www1453/trustscope/README.md

# TrustScope

## 1. 这是什么

TrustScope 是一台停带式来料检验工位：双 OV5640 经 PL 采集 1280×720 画面，三态判决在板端
裸机 PS 完成；缺角的四角覆盖通道在工位控制端运行（两通道设计见报告 §2.3）。它只回答一个
问题——这块板能不能判：输出 **OK / NG / 无法判定** 三态，判不了的一律判“无法判定”，绝不计为合格。
判定路径可审计：160×90 格逐格比对，每格 8×8 px = 0.4 mm/格，格均值差 > 30 灰且最大
8 连通组 ≥ 8 格判 NG。整张作业单 111 块板的实测结果见下一节。

## 2. 实测指标

以下为现场实测指标块原文（逐板 2026-11-01、连续运行 2026-11-02 夜→11-03 晨），**冻结不改写**；
它由 `data/` 里随仓库提交的数据算出，复算命令见 §3.2。

Field results (whole work order, 111 boards = B001-B100 + C101-C111, 2026-11-01 evening):
capability-internal detection **72.7%** (40/55 — contamination 18/25, bent 10/15, corner chips 12/15);
main-run anchor, batch 1-5 single session **75.0%** (36/48); good-board false alarms in two labelled
scopes — single run, production scope **15.0%** (6/40), and re-test adjudicated **8.8%** (3/34; 3/40 =
7.5% of all boards); fine scratches **0%** (0/16, a known capability boundary stated in the report).
Continuous run: 10.20 h, 12,626 samples, 99.7% OK (12,594), 0 NG, 32 refusals (0.3%, all inside the
first 30 min — a start-up transient), 1 restart (cause not located; verdicts consistent after).

The report states three limits explicitly: fine scratches pass by design, the CNN is implemented
but not in the verdict path, and hole/notch inspection is not implemented.

## 3. 复现（两条腿）

### 3.1 工具链腿：Vivado / Vitis 2023.1

**AMD Vivado / Vitis 2023.1** —— 硬件设计与 PS 裸机工程都用这个版本。赛纲 3.3.3.1 推荐 2026.1 / 2025.2，并要求其他版本在报告中说明且脚本可复现：版本声明见报告，可复现构建见 [`src/build/`](src/build/)。
器件 **XC7Z020（ALINX AX7020）**；10-24 出货构建 FCLK_CLK0 50.000 MHz，
WNS +0.908 ns / TNS 0 / WHS +0.037 ns，未满足约束的端点 0/140,009。

- **引脚约束**：[`src/two_fft.xdc`](src/two_fft.xdc)。16 条第二路相机引脚逐脚对照厂商 `an5642.xdc`，
  LCD 引脚对照厂商 `lcd_test.xdc`；改引脚号之前先对该表。
- **PS 裸机程序**：[`src/main.c`](src/main.c)（相机、I2C、MMU + D-cache、显示、判定主循环）；
  固件戳由 13 个源文件生成，见 [`src/build_id.h`](src/build_id.h)。
- **传送带侧固件**：[`src/stm32_conveyor_main.c`](src/stm32_conveyor_main.c)。
- **HLS CNN 与构建**：[`src/hls/`](src/hls/)（CNN 核、同源测试台、HLS 驱动；**不在判决路径上**）、
  [`src/build/`](src/build/)（Block Design 集成、构建与 XSA 导出 Tcl；**不含比特流**）。
- **构建与上板**：本仓库只带源码、约束与构建 Tcl，**不带 Vivado 工程、比特流、上板脚本**。从零构建的
  模块清单、资源与时序见报告 §2.3–§2.4 与 §6.2；上板的脚本序列与寄存器块记录在
  [`docs/HISTORY_20261021.md`](docs/HISTORY_20261021.md) 的“上板”一节——那里的 `ps_fft_dual/`、
  `ps_ui/` 路径取自 10-21 工作树，本仓库不含这两个目录，按记录原样保留，不作为本仓库的命令。

### 3.2 数据腿：三条命令

在仓库根目录执行；输入是 `data/` 里随仓库提交的实测 CSV，**不需要板子**。
Python 3.11+，只用标准库（画报告插图的 `tools/make_report_figures_20261103.py` 另需 `matplotlib`）。

```powershell
python tools/recompute_field_20261103.py     # 逐类检出率与误报率
python tools/threshold_sweep_20261103.py     # 限值 4-10 的工作点曲线
python tools/soak_20261101.py --report       # 10.20 h 连续运行的可靠性四项
```

各自打印什么（都能复算回第 2 节）：

- `recompute_field_20261103.py` → `IN-SCOPE DETECTION (adjudicated, all batches) : 40/55 = 72.7%`；
  `main-run-only anchor (batch1-5, one session) : 36/48 = 75.0%`；
  `false-alarm : 3/34 = 8.8% (judgeable) | 3/40 = 7.5% (all)`；
  `main run : NG 6 / UNSTABLE 3 / CANNOT 1 / OK 30`（即单次现场口径 6/40 = 15.0%）；
  逐类 `pollution 18/25 = 72.0%`、`bent 10/15 = 66.7%`、`corner 12/15 = 80.0%`、
  `scratch 0/16 = 0.0%`；末行 `ledger total: 111 boards = g40 + c25 + b15 + s16 + k15`。
- `threshold_sweep_20261103.py` → 表头 `t | good FA | pollution | bent | scratch | in-scope det`
  加 7 行（t=4…10）。t=8 行：良品误报 `6/36 = 16.7%`、能力内检出 `36/48 = 75.0%`；
  t=4 行：检出 `42/48 = 87.5%` 对误报 `14/36 = 38.9%`；收尾 `corner channel (independent): 12/15 = 80.0%`。
- `soak_20261101.py --report` → `rows : 12626`、`duration : 10.20 h  (36725.7 s)`、
  `mean sampling period: 2.9 s`、`OK 12594 (99.7 %)`、`NG 0 (0.0 %)`、`CANNOT 32 (0.3 %)`、
  `重启 (frame counter decreased) : 1`（帧计数下降 1 次）。

## 4. 导航

**目录对照（赛题 3.3.5.4：本仓库采用与推荐结构不同的组织方式，对照表放在本文件内）**

| 推荐结构 | 本仓库 | 内容 |
|---|---|---|
| `src/` | `src/` | PS 裸机 C（`main.c`）、PL 管脚约束（`two_fft.xdc`）、STM32 固件（`stm32_conveyor_main.c`）、HLS CNN（`hls/`）、构建 Tcl（`build/`） |
| `sim/` | — | 未分发；离线复算与五维否证见报告 §4 与 `tools/` |
| `build/` | `tools/` | 复算、阈值扫描、soak 报告、画图脚本 |
| `board/` | `docs/` | 上板与测量记录（250 份，按日期命名） |
| `data/` | `data/` | 现场 CSV、soak 采样、结果表 |
| `skill/` | `skill/` | 技能包（提示词模板 / 踩坑清单 / 校验脚本） |
| `report/` | `report/` | 设计报告（`trustscope_report.pdf`）+ 大模型协作记录（`llm_collaboration.md`、`llm_collaboration_evidence.md`） |
| `README.md` | `README.md` + `README.en.md` | 中英各一 |

- **完整设计报告**：[`trustscope_report.pdf`](report/trustscope_report.pdf)（27 页，含全部实测照片与数据）。
- **提交后勘误与补充**：[`docs/REPORT_ADDENDUM_20261104.md`](docs/REPORT_ADDENDUM_20261104.md)（节拍两态 + soak 不连续的准确表述）。
- **日期化工程记录**：[`docs/`](docs/)（250 个文件，按文件名日期排序）。先读
  [`docs/HISTORY_20261021.md`](docs/HISTORY_20261021.md) 顶部的三速率表——18.0 fps / 8.7–10.3 fps /
  约 1.6 次/秒不是同一个量。
- **数据与图**：[`data/`](data/)（实测 CSV、现场结果）、[`figures/`](figures/)（报告插图）。
- **技能包与检查脚本**：[`skill/`](skill/)。
- **大模型协作记录**：正文 [`report/llm_collaboration.md`](report/llm_collaboration.md) + 工程细节 [`report/llm_collaboration_evidence.md`](report/llm_collaboration_evidence.md)；证据索引 [`docs/AI_COLLABORATION_RECORD.md`](docs/AI_COLLABORATION_RECORD.md)（赛纲 3.3.5.3）。
- **目录对照（选题指南 3.3.5.4）**：[`docs/DIRECTORY_MAP_20261103.md`](docs/DIRECTORY_MAP_20261103.md)。
- **English version**：[`README.en.md`](README.en.md)。
