www1453/trustscope/docs/REPORT_ADDENDUM_20261104.md

# REPORT ADDENDUM — 2026-11-04

提交材料冻结（固件戳 TSC1CC73517D）之后、提交日当天整理的两个测量结论。
本文件只补充测量事实与口径，不改变报告任何指标；与报告正文表述不一致处，以本文件为准。
复算不依赖板子，命令见 §3（与 README §3.2 相同）。

## 1. 主循环节拍是"两个状态"，不是一个数字

| 状态 | 主循环判决节拍 | 出现条件 | 恢复性 |
|---|---|---|---|
| 冷启动态 | 8.07–8.28 Hz | 上电后首轮运行 | 可重复 |
| 退化态 | 约 1.6 Hz | 长时间运行 + 大量 JTAG 交互之后 | 三步重载不恢复；断电冷启动恢复 |

- 18.0 fps 是采集侧（PL + VDMA）速率；8.7–10.3 s/件 是报告表 1-1 的历史口径；约 1.6 Hz 与
  8.07–8.28 Hz 是 PS 主循环两个状态的实测。四个数不是同一个量，见
  [docs/HISTORY_20261021.md](HISTORY_20261021.md) 顶部三速率表。
- "降速只在退化态出现、断电冷启动后消失"这一事实是提交冻结后复测得到的，故在此补记。
  降速根因未定位；报告正文已按"两状态节拍"表述。

## 2. 10.2 h 连续运行（soak）的准确表述

- 主张：10.20 h 窗口内 12,626 次采样判决，12,594 次 OK（99.7%）、0 次 NG、32 次拒判（0.3%，
  全部集中在前 30 分钟的启动暂态）、1 次重启（帧计数下降，机制未定位）。
- 不主张："10.20 h 无间断连续运行"。物理行 12602 处存在一次记录不连续
  （t_ms 36,739,275 → 460 → 36,656,969；帧计数 61,408 → 60,223），其后 69 秒内 24 次采样判决正常。
- 采样全程处于退化态（约 1.64 Hz）——soak 测的是退化态可靠性，不是冷启动态。
- 复算：`python tools/soak_20261101.py --report`

## 3. 复算命令

```powershell
python tools/recompute_field_20261103.py     # 逐类检出率与误报率
python tools/threshold_sweep_20261103.py     # 限值 4-10 工作点曲线
python tools/soak_20261101.py --report       # 10.20 h 连续运行四项
```
