www1453/trustscope/docs/OPTICS_RECOMMENDATION_20261019.md

# 光学与分辨率建议（一页）

> 对象：AX7020 + AN5642（OV5640）双相机，检测裸 PCB，板 **64 × 44 mm**。
> 依据：`docs/DETECT_LIMITS_20261019.md` 的实测（1280×720 覆盖全板）。

## 现状：0.119 mm/px

横向 `64 mm / 527 px = 0.121`，纵向 `44 mm / 379 px = 0.116`，取 **0.119 mm/px**。

| 目标缺陷 | 需要 | 现状（0.119 mm/px） | 结论 |
|---|---|---|---|
| 缺铜/桥连/破孔 ≥0.5 mm | 4 px | 4 px ≈ 0.48 mm | **可检**（中/高对比度） |
| 低对比度缺陷 ≥1 mm | 8 px | 8 px ≈ 0.95 mm | **可检** |
| 走线断口 0.3 mm | 2.5 px | 2.5 px | **低于下限** |
| 走线断口 0.2 mm | 1.7 px | 1.7 px | **低于下限** |
| 走线断口 0.1 mm | 0.8 px | 0.8 px | **远低于下限** |

## 若验收标准是 0.1 mm 级缺陷

需要 **0.025 mm/px**（让 0.1 mm 占 4 px）。两条路：

| 方案 | 需要的水平像素 | 一次拍完？ | 成本/工作量 |
|---|---|---|---|
| **A. 换 5 MP 传感器**（如 2592×1944），视野不变 | **2592 px**（需 ≥2560） | ✅ 是 | 换模组 + 重配 DVP/时序/VDMA（PS 侧分辨率常量、VDMA HSIZE/stride、UI 缩放比） |
| B. 保持 1280×720，视野缩到 16 mm 宽 | 1280 px | ❌ 需 **4×3 = 12 次拍摄** | 加机械 XY 或传送带定位；节拍变成 12 倍 |

**建议 A**：一次拍完，节拍不变，主要改动集中在"分辨率常量"与"视野/焦距"两处；
B 会让节拍从"单板 1 次"变成"单板 12 次"，且引入定位误差源。

## A 方案在软件上的连锁改动（提前列出，避免低估）

| 位置 | 现在 | 改后 |
|---|---|---|
| `ps_ui/main.c` 的 `CAM_W/CAM_H` | 1280×720 | 2592×1944 |
| VDMA `HSIZE/STRIDE` | 3840 | 2592×3 = 7776 |
| 帧存占用 | 2.76 MB/帧 | **11.3 MB/帧**（四帧存 = 45 MB，DDR 够，但布局要重排） |
| MMU 映射 | 15 MB 窗口 | 需扩大（每路四帧 = 45 MB） |
| 渲染缩放 | 1280→640（÷2） | 2592→640（÷4.05，需改盒平均核） |
| 检测极限 | 0.119 mm/px | **0.0247 mm/px** ⇒ 0.1 mm = 4 px ✅ |

## 结论（给决策用）

- **如果只要求粗缺陷（≥0.5 mm）**：当前硬件够，**不要改光学**，把精力放在配准与稳定性上；
- **如果要求 0.1 mm**：**换 5 MP 模组**，并预留"重排 DDR 布局 + 放大 MMU 窗口 + 改渲染缩放"的工时
  （按今天的经验，这是一次 BD 重建 + 一次固件重构，约 1–2 天，且需要上板验证）。

## 边界

- 上述换算基于**一次**实拍（64 mm 板占 527 px），未考虑镜头畸变与透视；
- 0.1 mm 的"4 px 可检"是指**在中/高对比度下**；低对比度仍需 8 px（0.2 mm）；
- 未评估 5 MP 下**曝光时间/帧率**的代价（像素多 4 倍，同样光照下每像素光子更少）。

---

## 10. PC 端 5 MP 处理耗时（2026-10-19 实测）

把 720p 真实帧放大到 **2592×1944**（只增加像素数，不增加真实细节），跑同一条检测链：

| 阶段 | 1280×720 | 2592×1944 |
|---|---|---|
| 配准（金字塔） | 7.0 ms | **110.2 ms** |
| 平移对齐 | 13.6 ms | 68.8 ms |
| **差分（两侧高斯+相减）** | **42.2 ms** | **209.2 ms** |
| 阈值 | 0.8 ms | 5.4 ms |
| 形态学开 | 10.3 ms | 50.5 ms |
| 连通域标记 | 2.9 ms | 13.7 ms |
| **合计** | **76.9 ms** | **457.8 ms** |

- 像素比 5.47×，耗时比 **5.95×**（近似线性，说明没有隐藏的 O(n²) 行为）；
- **差分是热点**（5 MP 下 209 ms / 458 ms = 46%），优化应从这里开始；
- 配准在 8 像素粗网格上完成，**精度只有 ±8 px**（例子中真值 (6,−10) 恢复成 (8,−8)）——
  真实实现需要再加一级细化，代价约 +30 ms。

### 结论

**电脑侧在 5 MP 下约 0.46 秒/板**，而停带-稳定本身通常 0.5–2 秒 ⇒ **计算不是瓶颈，机械节拍才是**。
这条数据支持"5 MP 方案可行"，但**不构成**"检测精度足够"的证据（放大不产生细节）。
