www1453/trustscope/docs/RUN_20261030.md

# 2026-10-30 重扫操作卡（冻结增益验证）

> 站台当前状态（我已经做完，你不用管）：
> - 位流 `BIT_20261028_plfe_attempt.bit` 已载，两路相机 live
> - 固件 **`TSC1BE7E51A4`**（只含冻结增益）已烧
> - 曝光钉在 **8662**（AEC 自己收敛的值），`mean 529‰`、`clip 0`、`aec=1`
> - 背景已采：`bg_state=1`、`bg_medd=1`、**`bg_cells=1`**（14400 格里 1）
> - 冻结在生效：`frz_scale=256`(=1.0)、`frz_bias=512`(=0)、`frz_state=0x0103`（位0=1）

---

## 第 0 步：确认没有东西挡着（30 秒）

```powershell
cd C:\Users\user\Documents\trustscope
```

**屏幕上应该看到**：绿板区域干净、没有大面积绿色掩膜点。

---

## 第 1 步：扫 76 块原样板（约 25 分钟）

```powershell
python dl\host_qc\sweep.py --ref-label g0
```

**它会依次问你**：

```
[A] place the REFERENCE board (a known-good board, label g0) ... press Enter>
    → 放一块【确定表面干净】的良品，回车
    → 要看到：part_ref >= 400、MB_DIFF_OK=1、refq ... state=0（或 state=3 但 decl 说明清楚）
    → 若出现 "REFUSING TO START"：把那段贴给我，别硬来

board 1: place it, then press Enter  [q = finish]>
    → 放一块板，回车

board 1: label it (gN good / dN defective)>
    → 打标签，回车
```

**标签必须与 10-29 那批一模一样（顺序无所谓，配对按标签）**：

| 类别 | 标签 | 数量 |
|---|---|---|
| 良品 | `g0` … `g40` | 41 |
| 污染 | `d1` …（按原来的号）| 21 |
| 划伤 | 原来的号 | 12 |
| 缺角 | 原来的号 | 2 |

**跑完按 `q` 回车**。它会打印 `rows written : N`。

---

## 第 2 步：扫 10 块缺角板（约 4 分钟，另一个文件）

```powershell
python dl\host_qc\sweep.py --ref-label g0
```

- 参考板：**再放一块干净良品**（它会重新取参考，这是正常的）
- 然后 10 块缺角板，标签 **`d40` … `d49`**
- 跑完按 `q`

**注意**：这 10 块**不要**混进第 1 步的文件——它们是另一个 CSV，只用来量缺角的真实比例。

---

## 第 3 步：出配对表

把第 1 步结束时的 **CSV 路径**（屏幕上会打印）填进下面：

```powershell
python dl\host_qc\pair_compare.py `
  --old dl\host_qc\logs\sweep_20261029_181623_sweep.csv `
  --new "<第1步的CSV完整路径>" `
  --require-freeze
```

**它会打印**：

- 每类的**检出前后**（污染、划伤、缺角）
- 每类的**误判前后**
- **逐板 DAREA 配对差**（同一标签前后）
- **McNemar 精确检验的 p 值**（已修正为双侧，不会再翻倍）
- 良品分布 min/median/max，以及 5 和 7 的计数
- **冻结证据解码**（`frz_scale/bias/state`）——`--require-freeze` 会拒绝没有冻结证据的文件

**它会在这些情况下拒绝运行（exit 2/3）**：
- 标签集合与旧文件不同（会点名哪些标签变了）
- 文件里读不到冻结证据

---

## 第 4 步：缺角比例（可选，一条命令）

```powershell
python dl\host_qc\sweep_report.py "<第2步的CSV完整路径>"
```

---

## 判据（先写下来，不许事后改）

| # | 预测 | 成立条件 |
|---|---|---|
| ① | 良品尾巴收窄 | max **从 7 降到 ≤4**，且**没有一块 ≥6** |
| ② | 三块污染被收进 | **d7 / d9 / d13 从 5 升到 ≥6** |
| ③ | 误判消失 | **从 1 块降到 0 块** |
| ④ | 划伤不变 | **仍是 1/12**（冻结不解决这一类） |

**任何一条不成立 → 就写"预测失败"**，报告里照写。

---

## 出问题时

| 现象 | 意思 | 怎么办 |
|---|---|---|
| `REFUSING TO START ... the reference is not clean` | 参考板本身有瑕疵 | 换一块更干净的良品 |
| `no new comparison in 20 s` / `MB_DIFF_OK=5` | 配准拒绝（板子摆歪/出界） | 摆正；还不行按 `s` 记为拒判继续 |
| `aec_state=3` | AEC 卡住 | 停下，告诉我，我重钉曝光 |
| `bg_cells` 在扫描中变大 | 皮带动了或光变了 | 停下，告诉我，重采背景 |

**任何一步你拿不准，就停下把屏幕最后 10 行贴给我。**
