www1453/trustscope/docs/STATE_20261018_1500.md

# 状态快照 · 2026-10-18 15:00（回退与交接用）

> 代码提交：`637c839`（融合关闭 + 曝光写入验证）
> 上一版快照：`dl/STATE_20261018_1340.md`

---

## 一、系统当前是**可用**的（全部实测）

```
faultcode = 0                 ✓
帧率 18.x fps                 ✓
MODE = single exposure        ✓（融合关闭）
MEAN = 17 / 17                ← 场景本身暗（照明），不是软件
FOCUS = 130 / 123             ✓ 两路都对焦
EDGES = 13 / 125              ✓ 缺陷指标在动
CLIP_PM = 0 / 13‰             ✓ 无截顶
屏 = 有画面                   ✓（用户确认）
```

**⇒ 画面暗是照明造成的** ✓（`MEAN=17` 而 `CLIP=0` ✓ —— 没有过曝、只是光不够 ✓）

---

## 二、必须记住的四条（都是这一轮的代价）

### ① I2C 总线与相机的对应（**已验证，别再猜**）
```
I2C0 (0xE0004000) → **左**相机（面板 LEFT CAM）   → CAM_LONG_L / CAM_SHORT_L
I2C1 (0xE0005000) → **右**相机（面板 RIGHT CAM）  → CAM_LONG_R / CAM_SHORT_R
判定方法：给两条总线设 6 倍差异的曝光，**哪个视图亮就是哪条** —— 一次实验定死
```

### ② 融合当前是关的，原因是它自己有 bug
```
开融合时：程序自报 long exposure at/over clip = 0 (0.00%)  ← 声称全恢复
实际画面：MEAN = 4（几乎全黑）                              ← 但画面全黑
⇒ 融合的算术有问题，不是参数问题
⇒ 而且它**每帧把 SHORT 档写给两颗传感器**，覆盖一切外部设置
⇒ 掉电重启后立即读 I2C0=690(=CAM_SHORT_L)、I2C1=0 就是这个原因
⇒ 想再试融合：先读 fuse 那段代码，别再看画面猜
```

### ③ 程序与主机的传感器写入**都是好的**
```
程序启动写 4500/5500 → 主机读回一致 ✓
主机写 10000        → 两路都读到 10000 ✓
```
**⇒ 之前"写不进"的判断是错的** ✗（当时融合在每帧覆盖 ✓）

### ④ 改完必须**验证文件真的变了**
```
本轮有两次"以为改了其实没改"：
  - PowerShell 转义吃掉 python 补丁（标签没改成）
  - 工作目录错（C:\Users\user\Documents）⇒ 绝对路径找不到 ⇒ 文件未改 ⇒ 构建复用旧目标
⇒ 改完立刻 Select-String 看那一行，不要相信脚本打印的"成功"
```

---

## 三、代码现状

| 文件 | 状态 |
|---|---|
| `ps_ui/cam_i2c.c` | ✅ `I2C1_BASE` + `cam_write_bus(bus,…)` + `i2c_gap()`（settle）；`cam_set_exposure_bus(bus, exp)` |
| `ps_ui/main.c` | ✅ 四组曝光常量（L/R 各 long/short）+ `g_bracket_on = 0u`（第 2406 行）+ `MB_EDGES=148` 缺陷指标 |
| `ps_fft_dual/exposure_only.tcl` | ✅ 只写曝光、不烧比特流、双总线；当前写 7000 |

**曝光阶梯实测**（同一场景内可比）：
```
400→全黑  |  6500→MEAN47  |  7000→MEAN54-62  |  8000→MEAN55  |  9600→MEAN62  |  10000→MEAN17(场景更暗)  |  10656→MEAN106/CLIP64‰
```

---

## 四、剩余工作（按依赖顺序）

| # | 事项 | 起点 |
|---|---|---|
| **1** | **融合的算术 bug**（`CLIP=0` 却 `MEAN=4`） | 读 `ps_ui/main.c` 里 fuse 那一段（`FUSE_CLIP`、短档缩放系数） |
| **2** | **缺陷定位（坐标/尺寸）** | 把 `measure()` 里的强边缘点累加到 32×32 网格计数 → 取最大几格 → 换算坐标与尺寸（见 `dl/DESIGN_defect_detection.md`） |
| **3** | **照明**（物理） | 灯前加白纸柔光 + 灯放低到 10–20°；判据 `CLIP<10‰` 且 `MEAN 80–100` |
| **4** | **交付物** | 技术文档 / 视频 / RAR / GitHub / 承诺书 / 照片（**11/4 18:00 截止**） |

---

## 五、纪律速查

```
只改程序        ⇒ 只跑 ps_run.tcl      （不烧 PL ⇒ 屏不受影响）
改 BD / 换比特流 ⇒ 才跑引导 + ps_run    （会烧 ⇒ 之后若屏花，**只给屏断电**）
烧比特流只有一处：stereo_bringup_byname.tcl:251  fpga -file
```

**屏异常优先动作**：**只给屏断电**（`M43`），不要重启板子（会丢失寄存器状态）。

**回退命令**：
```powershell
cd C:\Users\user\Documents\trustscope
git checkout 637c839 -- ps_ui ps_fft_dual
Copy-Item safe_bitstreams\WITH_TOUCH_20261018.bit `
  'D:\BaiduNetdiskDownload\23_ov5640_dual\Vivado\two FFT\two FFT.runs\impl_1\design_1_wrapper.bit' -Force
cd ps_fft_dual; xsdb exposure_only.tcl; xsdb ps_run.tcl
```
