www1453/trustscope/docs/STATE_20261018_1535.md

# 状态快照 · 2026-10-18 15:35（融合病因查清 + 修复落地，融合仍默认关闭）

> 上一版：`dl/STATE_20261018_1500.md`
> 本轮完整实验记录：`dl/EXP_20261018_fusion.md`（**先读这份**）

---

## 一、系统当前状态（本轮实测）

```
faultcode = 0                     ✓
MODE = single exposure            ✓（g_bracket_on = 0）
MEAN_STORE_A = 18                 ✓（曝光 10000，VTS 1450）
显示屏相机区绿均值 = 18.0 / 18.2 / 17.6   ✓ 稳定（离散 0.6）
渲染循环 = 105–108 ms（9.2–9.6 fps）      ← **不是 18 fps**
捕获周期 = 103 ms（主机时钟 39 次跳变/4 s）
两路曝光 10000（回读一致），0x3503 = 0x07（AEC/AGC 手动）
```

**18 fps 那条旧记录不再成立**：左相机 VTS 仍是 1450（早先融合实验的残留，程序的
VTS 写只走 I2C0），帧长 103 ms。右相机 VTS = 740。**没有动它**——改了会影响
显示亮度（亮度与曝光 10000 绑定），而当前状态是可用且稳定的。

---

## 二、融合的真实病因（已测量，不是推断）

1. **"相位/缓冲差一帧"不成立。** 融合开时，12 次相干快照里两个 store **永远一样亮**
   （ratio 1.00–1.25），并随 PHASE 一起在 17 与 4–5 之间翻。**根本没有 long/short 配对。**
2. **直接原因：arm 太慢。** `i2c_gap()` 是 1.4M 次循环（实测 15–20 ms，注释写 2 ms），
   一次 arm = 6 次 gap ⇒ 一次 arm ≈ 100–120 ms。而捕获周期 103 ms ⇒ 曝光每 ~3 帧才换一次
   ⇒ 每个 store 在下次 arm 前已被同曝光帧覆盖 2–3 次。
3. 旧记录"融合输出 MEAN=5"= **采样时刻正好落在两 store 都是短曝光的相位**，不是融合把画面弄暗。
4. 修好 arm（真 2.5 ms + 0x3500 不变不写）后：循环 105 ms ≈ 捕获 103 ms，**配对出现**
   （12/12 有效，比例 2.4–3.0，`MB_PAIR=1`），`CLIPLONG=0`、`CLIP_PM=0`。
5. **但屏幕亮度摆动**：融合开 14.8/14.2/17.4/14.4，单曝光 18.0/18.2/17.6。
   原因是结构性的：2 个帧存时"没被写的那块"只在交班瞬间完整，渲染 53 ms/帧必然读到正在被覆盖的块。
   ⇒ **免撕裂配对需要 ≥4 个捕获帧存（BD 改动）**，与 `dl/HARDWARE_SAFETY.md` 2026-10-03 的结论一致。
   ⇒ 因此 `g_bracket_on` 保持 **0**。

---

## 三、本轮改了什么（都有备份，可回退）

| 文件 | 改动 |
|---|---|
| `ps_ui/cam_i2c.c` | `i2c_gap()` 改为 **GTIMER 计时 2.5 ms**（保留迭代上限）；`cam_set_exposure_bus` **跳过未变的 0x3500**；`cam_set_exposure` 改为调用它 |
| `ps_ui/main.c` | 新增 `MB_PAIR`(204) / `MB_PAIR_RATIO`(200)；**配对有效性判据**（ratio ≥1.5 且亮者 ≥8）；配对无效且两侧都暗时**跳过该帧绘制**；`g_bracket_on=0` 并写下完整病因注释 |
| `ps_fft_dual/ps_probe_now.tcl` | 新：传感器时序 + 捕获周期（主机时钟）+ 12 次相干配对采样 |
| `ps_fft_dual/ps_exposure_ceiling.tcl` | 新：曝光扫描 + 回读 + 每步捕获跳变数 |
| `dl/EXP_20261018_fusion.md` | 新：本轮全部测量与结论 |

**判据（下次直接用，不要靠画面猜）：**
- 配对是否存在 ⇒ `MB_PAIR` / `MB_PAIR_RATIO`；
- 捕获周期 ⇒ 主机时钟数 `CAP_FRPTR` 跳变（200 ms 探针只有 2 次跳变，样本不足，按"无数据"处理）；
- 屏上亮度 ⇒ `ps_live_dump.tcl` + 相机区绿均值，**同一会话内** A/B。

---

## 四、下一步（按依赖）

| # | 事项 | 起点 |
|---|---|---|
| **1** | **缺陷定位（任务 B）** | 强边缘点累加进 32×32 网格 → 取最大几格 → 发布 `MB_DEFECT_N/X/Y/W/H`；先量 mm/px |
| 2 | 融合若要重开 | 需 BD 加 ≥4 帧存（或把渲染+测量压到一帧内，53 ms vs 103 ms 理论上可行，但还要解决"另一块正在被写"） |
| 3 | VTS 不对称（左 1450 / 右 740） | 会同时影响帧率与亮度，要单独做单变量实验，不要和别的改动混 |
| 4 | 照明（物理） | 判据 `CLIP<10‰` 且 `MEAN 80–100` |
| 5 | 交付物 | 技术文档 / 视频 / RAR / GitHub（11/4 18:00 截止） |

## 五、回退

```powershell
cd C:\Users\user\Documents\trustscope
python dl\backup.py restore 20261018_151512__before-fusion-phase-fix   # main.c（本轮改动前）
git checkout <上一个提交> -- ps_ui ps_fft_dual
```
