www1453/trustscope/docs/ASK2_20261031_is_there_hope.md

# 求诊断（第二次）：这台设备的检测能力还有救吗？

> 只基于本包内的数据回答。所有数字都是实测，附复现方式。**我们不需要安慰，需要判断。**

## 1. 设备与判决链（决定性参数）

| 项 | 值 |
|---|---|
| 平台 | Zynq-7020 裸机 PS，单相机 1280×720 |
| 物方采样 | **0.05 mm/px**（1280 px 覆盖约 64 mm） |
| 曝光 | 20.00 ms，环境光（无方向性照明） |
| 格 | **160×90 格，每格 8×8 px**（每格 0.4 mm） |
| 格值 | 格内 **4 个采样点**（+2/+6 处）各取 3×3 均值，再平均 → **36 个像素**（不是全格 64 像素均值） |
| 判决 | `|live − ref| > 30 灰` 的格，**最大 8-连通组 ≥ 8** 判 NG |
| 判决区域 | 活体掩膜 ∩ 映射后的参考掩膜（两种掩膜都由"与空台面背景的差 > 24 灰"分割得到） |
| 参考 | 一块标准件，占位后由宿主命令取一次 |

## 2. 今晚的三组决定性实测

### 2.1 同一块板 + 它自己的参考 → 完美

取参考的那块板原地不动再拍一次：

```
cam0_ref=774   pts=769   darea = 0   （限值 8）
```

**残差为零。** 说明链路、配准、采样本身没问题。

### 2.2 正确参考下，三类板各一块 → 完全重叠

参考不变（就是上一步取的那块良品），依次换板：

| 板 | 内部 `darea`（限值 8） | 轮廓 `out_area`（限值 8） | 活体掩膜格数 |
|---|---|---|---|
| 第二块**良品** | **1** | **234** | 721 |
| 一块**划伤**（1–3 px 宽的沟槽） | **1** | 91 | 739 |
| 一块**缺角**（PCB 缺一块角） | **5** | 74 | 840 |

**内部判据：1 / 1 / 5，全部低于 8 —— 三类分不开。**
**轮廓判据：良品 234 最高、缺角 74 —— 方向是反的。**

### 2.3 关键异常：不同物理板的掩膜差三成

参考掩膜 774 格，换板后活体掩膜 721–840 格。**轮廓对称差（各向 1 格容差）在"良品 vs 良品"上就有 234 格。**

也就是说：**不同的物理板，连"哪里是零件"都分割得不一样，差约 30%。**

## 3. 我们已经排除的（每条都有数）

| 假设 | 结果 |
|---|---|
| 容差图退化 | 否证：161 份存档转储全是常数 30，包括曾经检出成功的那一天 |
| 对焦/成像退化 | 部分否证：`FOCUS` 现在是 120，高于历史正常值 106–116 |
| 黑背景提高对比度 | 提高了（`darea` 0–2 → 5–19），但黑底上板子的投影使背景变化 6019 格，掩膜和参考全乱 |
| 环形灯 | 同曝光下照度 1.5×、绝对微反差 0.95×、相对 0.63× → 对检出率无可测贡献 |
| 双视角 AND 融合 | 预注册判据 separation = −0.500，理论天花板仅 1.60× |
| 4×4 子块最大值代替格均值 | 峰值收回 1.95×，类别 AUC 0.5 |
| 颜色（R−B 色度） | 缺陷格不比板子更蓝 |
| 提高分辨率（传感器 1:1 裁剪 2.05×） | 实测生效，但视野降到 32 mm < 板宽 35 mm，板子装不进画面 |

## 4. 我们的判断（请判断这个判断对不对）

**结构性两难**：

- 判决区域取「活体 ∩ 参考」→ 缺角处活体掩膜没有零件 → **缺角永远不被比较**；
- 判决区域取「只由参考掩膜决定」→ 跨板掩膜差 234 格 → **假组淹没一切**（实测良品读 215，正确参考下也有 5）。

**所以问题不在判据参数，而在"用掩膜做区域/形状判断"这个做法本身跨板不成立。**

## 5. 想问的四个问题

**Q1｜0.05 mm/px 下，1–3 px 宽的沟槽，信息还在吗？**
我们的格值是 36 个采样像素的均值；一条 2 px 宽的线穿过一格，覆盖率约 5%（2×8/36），58 灰的对比度 → 格值只动几灰，而门槛是 30 灰。**在不提高采样密度、不换照明的前提下，有没有任何统计量能把这类缺陷从"板间掩膜差 30%"的背景里分出来？** 如果没有，请直接说没有。

**Q2｜"不同板掩膜差 30%"是不是这套方法的死穴？**
工业 AOI 在做"同一型号、不同个体的板"比对时，怎么处理个体间的分割差异？是用 CAD 掩膜、固定 ROI、还是允许更大的边界容差？我们这里的 30% 是正常的还是异常的（比如说明我们的分割阈值不适合这类板）？

**Q3｜"同一块板 + 自己的参考 → 残差 0"意味着什么？**
它说明链路本身完美。那是否意味着：**只要给每块板取一份自己的参考，检测就成立**？——但那样就等于"先拍一遍好板"，在产线上不叫检测。这个推理有漏洞吗？

**Q4｜如果还有救，最便宜的那一步是什么？**
约束：不能加硬件（不换镜头/光源/夹具），只能改软件或摆放。请给出**一个**你认为最可能见效的改动，并说明它的判据应该是什么（我们会在独立样本上验）。

## 6. 包内文件

```
ASK.md                          本文
dumps/good2/{d0,tol0,mask0}.raw  第二块良品（darea=1, out_area=234）
dumps/scratch/{d0,tol0,mask0}.raw 划伤板（darea=1, out_area=91）
dumps/chip/{d0,tol0,mask0}.raw    缺角板（darea=5, out_area=74）
dumps/same/{d0,tol0,mask0}.raw    取参考的那块板（darea=0）
images/zoom3x_d30.png           划伤板的 3× 局部：划痕人眼清晰可见
images/zoom3x_g1.png            良品板同倍数局部
pop_scan_*.csv                  四轮的判决记录
```

**转储格式**：`d0` = 160×90 **int16** 格值差，**`0x8000` = 未测量**（区域外）；`tol0` = 160×90 uint8 容差（全 30）；`mask0` = 160×90 uint8 活体掩膜（1 = 零件）。
