www1453/trustscope/docs/ASK_20261031_edge_tolerance.md

# 给外部审阅者（续）：边界容差这一步对不对？

## 背景（一句话）

单相机 AOI，1280×720、0.05 mm/px、160×90 细格（每格 8×8 px）。判决 = 格内 |live−ref| > 30 灰 的格，最大 8-连通组 ≥ 8 才算缺陷。
判决区域原本是「活体掩膜 ∩ 映射后的参考掩膜」。**缺角（PCB 缺一块角）因此永远不被比较**——缺了的那块在活体掩膜里就不是零件。

## 我们做了什么

把区域改成「只由映射后的参考掩膜决定」（编译期开关 `JUDGE_REFONLY=1`），于是缺角处也参与比较。
结果：缺角 0/10 → **6/10**；但良品从 0–3 涨到 **最高 22**（假组）。

## 我们离线算出的下一步（请审这一步）

假设原因是「板子轮廓 ±1 格的抖动」。用同一批转储，把超阈值的连通组分成**最外 1 格圈上**的与**内部**的：

| 类 | 连通组（全部） | **只算内部（去掉最外 1 格）** | 最外圈上的组 |
|---|---|---|---|
| 良品 ×10 | 最大 **8** | **最大 7** | ≤4 |
| 缺角 ×10 | 最大 94 | **最大 94** | ≤2 |

- 缺角的组几乎全在内部（c4：94 格中 94 格在内部；c3：74 中 74）。
- 良品最大的组是 8，去掉最外一圈后变 7 —— **刚好落到限值 8 以下**。
- 所以我们的结论是：**如果把判决区域改成「腐蚀 1 格后的参考掩膜」，良品 0/10 误判、缺角 6/10 检出。**

## 我们不确定的地方，想请你判断

1. **这个推理成立吗？** 我用"腐蚀**活体**掩膜"近似"腐蚀**参考**掩膜"（真正的实现会用后者）。这个近似会不会系统性低估边界抖动？
2. **余量够吗？** 良品最大 7、限值 8，只差 1 格，而样本只有 10 块。你觉得这算"成立的分离"还是"过拟合到这批样本"？
3. **腐蚀 1 格会不会把真实缺角也擦掉？** 我们能把缺角的内部分布算出来（c1=26、c3=74、c4=94、c5=24、c7=35、c9=10、c6=5、c8=5、c2=2、c10=1），但**不知道物理缺角有多深**（没有人工标注的缺陷像素，也没有缺角板的全分辨率图像）。在"腐蚀 1 格"和"缺角只有 1–2 格深"之间，你会怎么权衡？
4. **有没有更标准的做法？** 边界缺陷（material missing at an edge）在粗格（8 px/格）AOI 里通常怎么处理——是腐蚀、还是用形状/轮廓统计量、还是先做亚像素轮廓提取再比？
5. **限值 8 是否本身就不该用？** 划伤（细长）的连通组稳定落在 4–15，缺角在 2–94。两个类别的最优面积限值显然不同。是否应该按缺陷形状（细长 vs 块状）分两条判据，而不是一个面积上限？

## 数据在哪

- 转储：`pop_scan_20261031_ref1/<board>/{d0,tol0,mask0}.raw`
  - `d0`：160×90 **int16** 格值差，**`0x8000` = 未测量**（区域外）
  - `tol0`：160×90 uint8 容差（本批全 30）
  - `mask0`：160×90 uint8 活体掩膜
- 判定值时序：区域是 `JUDGE_REFONLY=1`（只由参考掩膜决定）
- 复现：`python dl/pop_scan_20261031.py --good 10 --scratch 0 --chip 10 --tag ref1`
