www1453/trustscope/docs/BELT_OPTIONS_20261103.md

# 皮带还能做什么 · 选项排名（2026-11-03）

> 结论：**今天皮带只能当"传送演示"，不能当"定位机构"。** 停位散布的根因不是触发阈值，而是**位置字 621 ms
> 才更新一次（=10-11 格行程）**+**电机低占空比不转**。只读研究与推导，未碰板子/皮带/XDC/PS 固件；硬件结论带行号，标"估计"的不当测量用。

## 0 三个数决定一切（E1/E2，可复算）

| 量 | 值 | 依据 |
|---|---|---|
| 发布 bbox/dx 的 PS 循环 | **1.61 loops/s（621 ms）** | `dl/soak_20261101.csv` 行 0..12599：59,200 次循环 / 36,739 s（10.2 h）；同一计数 10-28 是 **5.61 loops/s**（`dl/LOOP_MEASURE_20261028_step1.md:228`）、10-24 是 7.3（`dl/FIX3B_20261024_tear.md:8`） |
| 每次更新之间板子走 | **9.8-11.3 格** | 15.8-18.2 格/s（`dl/HARDWARE_CONNECTION_20261102.md:38`）× 0.621 s |
| 同一 1.0 s / 100% 行程 | **5 / 14 / 18.5 / 32.5 格**（sd 11.5，打滑） | `dl/HANDOVER_20261031_EVENING.md:239`、`dl/OAM_MANUAL_20261101.md:105` |

**所以**：凡"读邮箱→停带"的方案，量化步长就是 10 格；要 sd ±2 格，邮箱须 **≤408 ms** 更新一次（2√3·2/17），今天差 1.5 倍。
实测停位 83.5/95/97.5/107.5（**sd 9.9、极差 24**，`dl/belt_pos_20261101.py:94`）≈ **2.3 个更新周期**，而混叠项只有 3.0 格 sd ⇒ 至少 2/3 来自"运动时掩膜掉/贴边"（`dl/_belt_watch.log`：pts 830→42-58、bbox=-1 约 1.4 s，随后整幅掩膜 2087/3179）。
另：**"±2 格才能锁上"与日志不符**——6 格偏移照样 `reg=1/diffok=1`（dx=-766，`dl/belt_pos_20261101.log` 19:37:54）。

## 1 排名

| # | 方案（场景） | 需要什么 | 预期停位重复性 · 依据 | 实施 | 无操作员可测 |
|---|---|---|---|---|---|
| ① | 手放板 + 皮带只做传送（**今天视频**） | 无，已是既定方案（`dl/TOMORROW_20261103.md:129`） | 不适用：判决帧由手放保证在参考位；传送落点 5-32.5 格必在配准 ±49 格内（`ps_ui/main.c:2168`） | 0 | 脚本可预跑，拍摄要人 |
| ② | 修 PS 循环 1.6→~6 Hz（**报告第一**） | 先定位变慢原因（DA/CNN/发布器/轮询） | 混叠项 3.0→0.8 格（模型）；sd 9.9 大半来自掩膜项，只能保证**改善**（估计） | 1-3 h 诊断；动固件则重烧 | 可（纯只读） |
| ③ | 机械挡块（硬件） | 现成木块/夹钳，操作员装 | 位置=挡块面，传感与计时移出位置链；**估计** 0.5-1.2 格（0.4 mm/格，`dl/ASK2_20261031_is_there_hope.md:12`） | 30-60 min（今天无人） | 不可 |
| ④ | 触发点 117→~107 | 改一行 + 一块板标定 | 只改**均值**（今天系统性晚 ~17 格）；散布不变，sd 9.9 | 改 5 min + 标 30 min | 不可（门可离线回放验） |
| ⑤ | 一次标定 + 单程开环 `belt_shot.py` | 库内已有；板需在视野 | **±11 格（1sd）**；文件自称"±4 格"是未测目标（`dl/belt_shot.py:16`） | 0（工具现成） | 不可 |
| ⑥ | 两段式：快进 + 低速蠕动 | 先要"低速能转" | 若 3 格/s 可用：sd≈0.5 格（3×0.621/√12）；今天不可用，见⑦ | 数小时 | 不可 |
| ⑦ | 降 duty（阶梯标定） | 现成 `run(duty)` | **0 格**：40/70% 只嗡不动、0.25 s 点动不动（`dl/stm32_conveyor_main.c:14-19`、`dl/belt_auto_20261031.py:7`）；无 duty 阶梯日志（`dl/BELT_BENCH_20261028.md` §9 整表空白） | 10 min | **可**（贴胶带当目标） |
| ⑧ | 反向（INA/INB 交换） | **要固件**：`stm32_link.py` 无反向命令、RUN 的 D1 恒 0（`dl/host_qc/stm32_link.py:275`）；固件"方向固定正转"（`dl/stm32_conveyor_main.c:12`，CH2 恒 0 `:235`） | 无改善：只把过冲换成 5-32 格的反向随机跳 | 1-2 h + 重烧（作废 `TSC1CC73517D` 归属） | 不可 |
| ⑨ | 落点重采参考 MB_CMD=9 | 只需主机写邮箱 | **不能**：把**当前帧**当参考（`ps_ui/main.c:19062-19067`），参考=被测件本身，判决成空判 | 0 | 理论可，但**不该做** |
| ⑩ | 放宽配准搜索 REG_R | **固件常量** `REG_R 128`（`ps_ui/main.c:2168`） | 无用：±49 格已覆盖行程；6 格偏移早就锁上（19:37:54） | 重烧 | 不可 |

## 2 逐条

- **① 手放+传送**：唯一零风险零工时。皮带段只拍"电机转、板被带走、STOP、500 ms 看门狗"，判决帧用已放好的板；代价是
  看不到"自动定位"，与报告"皮带为传送非定位"一致。
- **② 修循环速率**：**唯一按倍数改善**的杠杆——1.61 是 10-28（5.61）的 1/3.5；`DIFF_EVERY=16`（`ps_ui/main.c:1896`）在 621 ms 下
  意味着一次真比较 10 s、可判 ~30 s（报告里"10 s/件"因此要改）。
- **③ 机械挡块**：本台唯一能把误差压到 1 格以内的机构，也是文献标准解（"overrun 随负载/速度变"→ 恒行程或机械限位，[Oriental Motor 案例](https://www.orientalmotor.com/case-studies/applications-stepper-motors-pkp-conveyor-using-stop-sensor.html)）；前提是板真被推到挡块（最小行程 5 格也要保证到）且皮带在板下打滑。**需操作员。**
- **④ 触发点前移**：117 是由"参考位 bx1=119"倒推的（`dl/belt_pos_20261101.py:86-90`），漏了"看到后还要走 1-2 个更新期"；
  前移 ~10 格把均值对到 79，**不改散布**。另：bx1 会贴到 158 画幅边，阈值只在饱和前有意义。
- **⑤ 单程开环**：逻辑对，但标定本身被打滑（sd 11.5）污染 ⇒ 落点 ~±11 格，不是 ±4；适合当"能送件"镜头，不适合判决镜头。
- **⑥ 两段式**：架构正确（慢速下混叠项可忽略），但执行器侧不成立；要先解决⑦的机理（提高电机供电/换减速比，均属硬件，且仓库未记录电机额定电压 → 不能乱升压）。
- **⑦ 降 duty**：两次独立实测的结论，不是猜测。**无操作员也能做**：贴一段胶带当目标（白皮带无纹理、帧差看不出运动，
  `dl/VIRTUAL_PHOTOEYE_RESULT_20261101.md`），跑 100/90/80/70 阶梯记 stall 阈值。
- **⑧ 反向**：先查后说——**没有**。协议只有 STOP/RUN/HEARTBEAT/GET_STATUS/WORD/KNOB（`stm32_link.py:9`、`:275`）。要做须改固件+
  重烧，新构建戳让报告里按 `TSC1CC73517D` 归属的测量失去可追溯；即便做了，5-32 格随机跳也修不了精度。**不推荐。**
- **⑨ 落点重采参考**：只需写 20 到 MB_CMD（不碰固件），但把当前帧（含缺陷）学成"良品"，`darea` 恒 0 ⇒ 判决失去意义；只对已知良品
  才成立，换板就得重采 = 每件空判。
- **⑩ 放宽搜索**：`REG_R` 是编译期常量，改=重烧+新戳；而日志已证明 ±49 格够用，0.7 格 dx 就出 darea=118 说明敏感项是**残差**不是范围。**不做。**

## 3 今天就能做（零风险，不碰硬件）

- `dl/belt_pos_20261101.py:107` **`CELLS_PER_S = 6.0` 已过期**（真实 15.8-18.2）⇒ `run_for()` 只给 1/3 行程，改一行。
- 报告节拍"10 s/件"（`dl/HANDOVER_20261031_EVENING.md:244`）是按 ~6 loops/s 算的；今天 1.61 ⇒ 应写 **30-40 s/件**。
- **停带滑行距离从未测过**（`dl/BELT_BENCH_20261028.md` §4 表全空）——停位预算唯一缺项，胶带+手机 30 fps 可补，不需操作员。

**今天视频的唯一推荐：①**（手放板拍判决，皮带只拍传送+STOP+看门狗）。②③⑦ 是报告下一阶段的三件事。
