www1453/trustscope/docs/DETECT_LIMITS_20261019.md

# 检测极限扫描（2026-10-19）

> 目的：回答一个决定整条技术路线的问题——**这套镜头在这个取景下，能看到多小的缺陷？**
> 全部离线完成（用板上 dump 的真实帧），不涉及上板。

## 1. 方法

- 输入：`ps_ui/pair_storeA.bin`（真实相机原始帧，1280×720×3 BGR，stride 3840）；
- 板掩模：亮度阈值 + 形态学开 + 取最大连通域 ⇒ 157,562 像素，bbox `x 216..743, y 229..608`；
- 缺陷：在板中心（487,416）处，把一块 `size × size` 的真实纹理**压暗** `amp` 灰阶
  （`low=40, mid=90, high=160`）；
- 位移：整幅图移动 `(+3, −5)` 像素（**非环绕**，用 `ndimage.shift(..., mode='nearest')`）；
- 配准：4× 降采样粗搜 + 全分辨率细搜 + 抛物线亚像素拟合；
- 差分：两侧同核高斯平滑 → 绝对差 → 板掩模内阈值 18 → 形态学开 → 最小面积过滤。

## 2. 过程中修掉的两个**测量自身**的错误（重要）

这两条如果不修，得到的会是一个"好看但假的"结论：

| 错误 | 表现 | 根因 | 修复 |
|---|---|---|---|
| **对齐符号用反** | 误报 **82 个/板**，且"命中"缺陷只是巧合 | 配准给的是 `cg[y,x] ≈ tg[y−dy, x−dx]`，对齐应移 `(−dy,−dx)`；我按 `(dy,dx)` 又移了一次，等于位移翻倍 | 改成 `shift(cg, −dy, −dx)` |
| **用环绕平移模拟位移** | 边界出现巨大差异 | `np.roll` 是环形的，从一边卷出去的内容会从另一边卷回来 | 改成 `ndimage.shift(..., mode='nearest')` |

修好后配准精确到 **`(3.00, −5.00)`**（真值 3,−5），相关系数 **1.000**。

## 3. 扫描结果

| 缺陷边长 | 低对比 (40) | 中对比 (90) | 高对比 (160) |
|---|---|---|---|
| **2 px** | ✗ 漏检 | ✗ 漏检 | ✗ 漏检 |
| **4 px** | ✗ 漏检 | ✓ 检出（误报 1） | ✓ 检出（误报 1） |
| **8 px** | ✓ 检出（误报 1） | ✓ 检出（误报 1） | ✓ 检出（误报 1） |
| **16 px** | ✓（误报 1） | ✓（误报 1） | ✓（误报 1） |
| **32 px** | ✓（误报 1） | ✓（误报 1） | ✓（误报 1） |

原始数据：`dl/proto_out2/sweep.txt`；示例图：`dl/proto_out2/sweep_mid_*.png`。

## 4. 结论

1. **检测下限：4 像素（中/高对比度），8 像素（低对比度），2 像素在任何对比度下都检不出。**
2. **误报 1 个/板**（修好对齐后）。
3. 板区宽约 `743−216 = 527` 像素。**要换成物理尺寸，需要这块 PCB 的实际宽度**——
   例如板宽 100 mm，则约 `0.19 mm/px` ⇒ 4 px ≈ 0.76 mm，8 px ≈ 1.5 mm。
   **这个换算需要你提供板宽**，我不会猜。

## 5. 这意味着什么（对路线的影响）

| 如果要检的最小缺陷 | 结论 |
|---|---|
| ≥ 8 px（板宽 100 mm 时约 1.5 mm） | **当前光学足够**，模板差分可行 |
| 4–8 px | 需要**提高对比度**（补光/换角度），或缩视野 |
| < 4 px | **当前镜头/取景不够**，必须缩视野或换更高分辨率，算法再怎么改都没用 |

## 6. 诚实的边界（这一节不能省）

- 缺陷是**合成**的（压暗一块真实纹理），**不是真实断路/缺口**；
- 只用了**一帧、一种光照**；
- 误报计数是**同一帧与自身**的比较（曝光/噪声完全一致），真实系统里两帧之间有噪声、
  有光照波动，误报会更多；
- 未评估**旋转/缩放**失配（真实系统会有），目前只做了平移；
- 未在板端验证（本原型跑在电脑上）。

## 7. 下一步（需要上板或需要你提供信息）

1. **板宽（mm）** —— 把像素换算成物理尺寸；
2. 一块**真实有缺陷**的板 —— 用同样流程测真实检出率；
3. 两次**独立拍摄**（而不是同一帧）—— 测噪声/光照波动对误报的影响；
4. 加入旋转 ±1° 的配准 —— 测机械放置误差的容忍度。

---

## 8. 物理换算（2026-10-19 补，板 64 mm × 44 mm）

横向 64 mm / 527 px = **0.121 mm/px**；纵向 44 mm / 379 px = **0.116 mm/px**；取 **0.119 mm/px**。

| 缺陷尺寸 | 像素 | 物理 |
|---|---|---|
| 2 px | 2 | **0.24 mm** — 检不出 |
| **4 px** | 4 | **0.48 mm** — 中/高对比度可检出 |
| **8 px** | 8 | **0.95 mm** — 低对比度可检出 |
| 常规走线 0.2 mm | 1.7 | **小于 2 px，处于检不出的区间** |
| 常规走线 0.3 mm | 2.5 | 同上 |

### 这条换算说明什么（关键结论）

**当前光学（1280×720 覆盖 64 mm）能检的是"粗缺陷"：≥0.5 mm 的缺铜、短路、破孔。
细走线（0.2–0.3 mm）上的断口只有 1.7–2.5 px，落在检不出区间——不是算法问题，是采样率问题。**

### 要检 0.1 mm 级缺陷，需要多少分辨率

要让 0.1 mm 占 4 px，需 **0.025 mm/px**：

| 方案 | 需要的水平像素 | 现实性 |
|---|---|---|
| 同一视野、更高分辨率传感器 | **2560 px 宽**（≈5 MP，如 2592×1944） | **可行**：同款镜头视野不变，0.1 mm 正好 4 px |
| 保持 1280×720、缩小视野 | 视野缩到 **16 mm 宽**，需分 4×3 = **12 次拍摄** | 需要机械 XY 或传送带定位 |
| 保持现在的 0.12 mm/px | — | **只能检 ≥0.5 mm 的缺陷**，这是硬边界 |

### 对项目范围的影响（必须现在决定）

| 如果验收标准是 | 结论 |
|---|---|
| 粗缺陷（缺铜、桥连、破孔，≥0.5 mm） | **当前硬件够**，直接做检测 |
| 细走线断口（≤0.2 mm） | **现有镜头不够**，必须换 5 MP 或改多拍 |

---

## 9. 真实条件下的测试（2026-10-19 补）

用**两张真实采集的帧**（`pair_storeA` 长曝光、`pair_storeB` 短曝光）做"模板 vs 待检帧"，
先做亮度归一化（在板区拟合增益+偏移：gain 2.084, offset 62.6），再亚像素配准。

| 条件 | 相关系数 | 候选数 |
|---|---|---|
| 两张不同曝光帧、**无缺陷** | **0.9323** | **34** |
| 旋转 0.25° | 0.9333 | 36 |
| 旋转 0.50° | 0.9314 | 34 |
| 旋转 1.00° | 0.9260 | 44 |
| 旋转 2.00° | 0.9146 | 42 |

### 结论（重要）

1. **不同曝光的两帧不能直接互相比较**：亮度归一化要放大 2 倍，短曝光的噪声被同步放大，
   相关系数只有 0.93（同一帧自比是 1.000），误报 34 个。
   ⇒ **模板帧与待检帧必须用同一档曝光**——这不是建议，是方法成立的前提。
2. 这也解释了为什么我们没有更多数据可测：手上只有一对**长/短**帧，
   **没有同曝光的两帧**。四帧存里 0 与 2、1 与 3 应是同一曝光档，
   下次上板各 dump 一张，才是有效的"两帧一致性"测试样本。
3. 旋转测试因此也无效（基线本身就有 34 个误报，看不出旋转的影响）。

### 下次上板要补的两张图（明确指令）

```
# 四块环里同曝光的两块：0x10000000 与 0x10C00000（长档），0x10400000 与 0x12000000（短档）
mrd -force -bin -file store_c0.bin 0x10000000 691200
mrd -force -bin -file store_c2.bin 0x10C00000 691200
# 两次之间移动一下物体再放回，模拟"同一块板放两次"
```

有了这对图，才能回答"**同一块板放两次，误报多少**"——这是模板法能不能用的决定性数字。
