www1453/trustscope/docs/EXP_vsync_lock.md

# 预测与判据：把相机 vsync 暴露给 PS（BD 改动）

> 写于动手之前（claim-discipline R4）。改动 = 帧存无关，只加一位输入。

## 背景（已测得的事实）

- `alinx_ov5640_0` 没有任何 AXI 寄存器（地址表里没有它）⇒ 拿不到现成帧计数。
- 相机 0 的 vsync 网名：**`/cmos_vsync_0_1`**（dir=I）。
- 探测拼接器 `/vtc_probe_concat` 现有 **9 路**（In0–In8），输出接 `axi_gpio_0` 的 `gpio2_io_i`。
- PS 现在读 `0x41200008`：bit4 = VDMA 帧指针（10 Hz），其余位 25–62 kHz。
- 冷启动后的单曝光基线：19 fps、`faultcode=0`。

## 改动

1. `/vtc_probe_concat`：`NUM_PORTS` 9 → 10；
2. 把 `/cmos_vsync_0_1` 接到 `/vtc_probe_concat/In9`（**追加在末位，In0–In8 位序不动**，
   保证 PS 里 `CAP_WRBIT = 0x10`（bit4）仍然指向帧指针）；
3. `axi_gpio_0`：每通道宽度 +1（双通道则 `C_GPIO_WIDTH` = 2×(9+1) = 20）；
4. 重新综合 + 实现 + 生成比特流；完整引导；`ps_run`。

## 假设矩阵

| # | 假设 | 若成立，应观测到 | 若成立，**不应**观测到 | 区分实验 | 成本 |
|---|---|---|---|---|---|
| H1 | 新 bit（第 9 位）就是相机 vsync | CPU 端 200 ms 窗口计数 ≈ **2 次/0.2 s**（10 Hz），且与 bit4 同量级 | 25 kHz、60 Hz、或恒 0 | `ps_bitcount` 读 150+9 | 低 |
| H2 | 接到的是行/像素级信号（接错网） | 计数 ≥ 1500 次/0.2 s（≥7.5 kHz） | 与 H1 的 2 次同量级 | 同上 | 低 |
| H3 | 宽度改动破坏了原探测口 | bit0–bit8 的计数**偏离**改动前的记录（bit0 11859 / bit4 2 / bit8 159） | 前九位计数与记录一致 | 同一次读取即可对照 | 低 |

**H3 是对照组**：它同时检验"我的改动有没有把已经能用的东西弄坏"。
若 H3 成立（旧位变了），先回滚 BD，不解释新位。

## 预测（具体到数值）

**若 H1 成立**：

- `bit9 transitions / 0.2 s` 落在 **1–3**（10–15 Hz）；
- 且 `bit4` 仍为 **2**（10 Hz）、`bit0` 仍在 **1.0e4 量级**；
- 若它同时与 bit4 的相位固定（vsync 领先 VDMA 若干行），则可用于锁相。

**若 H2 成立**：`bit9` ≥ 1500/0.2 s，且与 bit0/bit1 同量级 ⇒ 接错，回到网表核对。

**若 H3 成立**：`bit0`–`bit8` 任一偏离记录 ⇒ BD 改动有副作用，立即回滚。

## 判据（先写死，跑完只对照这里）

- **接受**：H1 成立 且 H3 不成立 ⇒ 可以进入"arm 锁 vsync"的实现。
- **拒绝**：H2 或 H3 成立 ⇒ 回滚，写清哪一条被推翻。
- 任何情况下都不以"构建 Complete"作为成功判据（那是 E1）。

## 风险

- 重新综合约 25–40 分钟；期间板子继续跑当前比特流（可用）。
- 若综合失败或位流异常：`safe_bitstreams/WITH_TOUCH_20261018.bit` 是回退用的已验证比特流；
  BD 文件已备份：`backups\20261018_171445__before-vsync-probe-bd`。

---

## 附：照明条件（2026-10-18 晚，用户实测，待解决）

用户把灯光调暗后实测（单曝光、`0x3503=0x03`）：

| 量 | 结果 |
|---|---|
| 曝光 10000 / 20000 / 30000 / 40000 | MEAN **19 / 21 / 21 / 21** ⇒ **曝光在 10000 以上被钳位，无效** |
| 增益 0x20 → 0xF0（最大） | MEAN **9 → 44**，CLIP_PM 0 → 8 |
| 降光前（灯全开） | CLIP **924‰**（灯的热点把 92% 通道打爆） |

**结论**：当前光量约为达到 `MEAN 80–100` 所需的一半；**只有"加白纸/柔光纸"能同时满足
`MEAN 80–100` 与 `CLIP<10‰`**（热点被扩散，光量还在）。用户 2026-10-18 暂时无法加柔光纸，
**先记录，待补**。

**在柔光到位之前，融合的验收判据 (4) 中的 `MEAN 80–100` 不可用**；可用的判据是：
`CLIP_PM<10‰`、配对成立、屏上离散 ≤ 同口径基线。融合的**频闪/撕裂**是否只在
"CLIP 很高（如 924‰）"时出现，可用当前的低截顶场景（CLIP 8‰）检验。
