www1453/trustscope/docs/HANDOVER_20261024.md

# Handover 2026-10-24 (rotation registration + the capture-store root cause)

Board up, running build `TSC1 / 49CF0B22` (commit `8e8f306`), loaded with
`ps_fft_dual/strict_load_cores.tcl`. `MB_READY = 1`, the no-part refusal path is intact
(`MB_PART_PTS` 40-70, `MB_REG_STATE` 2, `MB_DIFF_OK` 5, verdict 2).

## Commits this session

| commit | what |
|---|---|
| `200d86e` | stage 5: the registration estimates rotation (shift + scale + angle), sub-pixel refinement, `MB_REG_ANGLE`/`MB_REG_ANGLE100` |
| `8e8f306` | fix 3b: the capture-store index measured (Gray LSB, 27.2 ms per store), selection replaced, MB_FP_INVERT/denominator bugs fixed, A/B measured |

Docs: `dl/STEP0_20261024_mask_empty.md`, `dl/STAGE5_20261024_rotation.md`,
`dl/FIX3B_20261024_tear.md`.

## Step 0 answer: (a) there is no part in view

The camera looks at the room (five strips + `ps_ui/s24_stitched_view.png`). At margin 12
the mask finds 43 points on the stitched frame against a 400 floor, while the same rule
finds 1,655-2,599 on real part frames from 2026-10-23. Margin 6 would find 597 (the box
on the floor) and was refused. **The operator must re-frame the camera** (steps in the
STEP0 doc), then `MB_CMD = 9` and qc_state. Nothing was tuned.

## What is verified

* Rotation: the offline known-answer test (`ps_ui/st5_rot_check.py`, a port of the C
  integer arithmetic) recovers 0.16/0.5/1.0/4.4/-4.4 degrees exactly, with the
  independent top-edge slope in agreement (0.01-0.45 deg) and 0 blob cells on a good
  part. The C search order (rotation before scale) and sub-pixel scoring are backed by
  measured negatives (1.75 deg instead of 4.4 at 4.4 with the old order).
* Tearing: CAP_FRPTR bit 4 is a Gray LSB (parity 0,1,1,0 at stores 0,1,2,3, one store
  every 27.2 ms), measured by known-answer canary injection (MB_CMD = 6). The replaced
  edge-synchronised selection measured 2.9% torn renders against 81.6% in the positive
  control (row detector), down from ~53% before.
* The board builds (0 collisions, layout checks pass) and runs both commits.

## What is NOT verified (human-dependent)

1. Firmware angle on a physically rotated part; exact experiment in
   `dl/STAGE5_20261024_rotation.md`.
2. Tear rate on a scene with real motion; exact experiment in
   `dl/FIX3B_20261024_tear.md` (move a hand/paper while tear_ab runs).
3. `MB_CAP_PERIOD` is a sparse-sampling estimate and reads 88-141 ms against the true
   54.4 ms edge interval; the wait threshold is looser in practice than its 1/8 intent.
   The 2.9% figure was measured under that looser margin.

## Tasks 3-5: NOT STARTED

They were not attempted because the session budget went to Step 0 and to the Task 2 root
cause, which was a precondition: with the old selection ~53% of sampled frames could be
torn, so averaging frames (task 3), measuring fine cells (4) or calibrating a local
threshold (5) on that input would have been measuring a capture defect. The next session
should start with task 3 (`st5`/`st3` harnesses are reusable):

* Task 3 (average N frames): accumulate `cell_mean4` + `latt` values over N consecutive
  completed stores, wait for an edge between samples (the edge-synchronised selection
  from fix 3b), publish N and the cell-difference sigma. Budget: N=4 at ~27 ms per store
  plus the wait; the loop is already 136 ms because of the edge wait, so prefer
  accumulating across comparison invocations if the display rate matters.
* Task 4 (fine cells inside the mask): the Python port in `ps_ui/st5_rot_check.py` already
  applies the full transform to a synthetic rotation and reports the 16x16 blob count
  (0 at every angle); extend it to 8x8 cells inside the eroded mask before touching C.
* Task 5 (local threshold): derive it from the cell's own within-cell spread (the four
  5x5 box means are already computed) and publish the worst/median threshold; measure on
  the rotated frames and on a synthetic low-contrast change.
