www1453/trustscope/docs/HANDOVER_20261024_1520.md

# Handover 2026-10-24 (15:20) — after Stage 2 (multi-frame averaging) and Stage 5 (contour features)

Board up, running `TSC1` / `2E19C0C8`, flashed with `ps_fft_dual/strict_load_cores.tcl`
(firmware only; no bitstream rebuild, no power cycle, no running-VDMA poke this session).
`MB_READY` = 1, part in view (part_pts 758 / ref 678 / used 449), `MB_AVG_N` = 8,
`MB_AVG_CNT` = 8, loop 156.5 ms = 6.39 fps, capture period 150 ms, tear 5.8% of renders.

## Commits

| commit | what |
|---|---|
| `3221e97` | **Stage 2**: the live side is the mean of 8 frames — the noise tail is gone, the drift is exposed |
| `dfb2a7e` | **Stage 5**: contour feature matching — labelled, classified, drawn |
| `d6e8b02` | docs: the Stage 2 table's build column named the wrong builds |

Docs: `dl/STAGE2_20261024_average.md`, `dl/STAGE5_20261024_contour.md`.
Harnesses: `ps_fft_dual/st2_accept_20261024.tcl` (one row per independent comparison),
`st2_cost_20261024.tcl` (paired loop-time A/B), `st2_state_20261024.tcl`,
`st2_rowband_20261024.tcl`, `st5_selftest_20261024.tcl` (MB_CMD = 13), `st5_draw{,2,3}*.tcl`,
`ps_ui/st5_blob_check.py` (the 14-case known-answer port).

## Stage 2: shipped, and what it really did

N = 8 frames, only while `MB_READY` = 1 and only frames the tear detector did not flag,
presented to both the registration (the lattice) and the comparison (the 16x16 cell means).
137 independent comparisons at N = 8: **cells 0 in 135, 1 in two, none at or above the 8-cell
limit** (at N = 1: 0 in 36 of 43, 8..9 in two). sigma of the cell difference 7.2 → 4.4 grey
counts. Cells over the threshold before the blob rule: 40 (median) → 0. Loop time unchanged
(156.55 ms at N = 1, 4 and 8, measured back to back on one scene) — the work is hidden by a
wait, not free.

**The finding that matters more than the win**: averaging stopped HIDING a registration
drift. On the shipped build, a drift to −0.20 deg / −3.5 px was followed by cells = 0 with
193 cells over the threshold — the noise scattered them and the 3x3 blob rule removed them.
The firmware therefore reports PASS on a part it has just mis-registered. At N = 8 the same
drift leaves a clustered 14..25-cell difference. Drift was seen in 2 of 3 runs at N = 4
(before the tear gate) and 0 of 2 at N = 8, so the N = 8 rate is unresolved — item 1 of the
Stage 2 document has the repeat experiment (5 runs, count `MB_REG_MODE` != 2).

The row profile of the difference (`MB_DIFF_ROW`, 45 words) on a still scene is a smooth
±5-count periodic modulation with a ~12.5-row period, 3.6 cycles down the frame: the
rolling-shutter/mains bar as a spatial structure, below the 14-count threshold.

## Stage 5: shipped, no accuracy claimed

8-connected labelling of the surviving cells, per-blob area / bbox / centroid / fill /
aspect / attachment to the part outline / enclosed holes, and a rule table publishing hole /
notch / contamination-foreign-object / large-area-mismatch / unclassified / too-small with
the bbox; the box is drawn in the overview only and was verified by reading the framebuffer
back (240 px exactly at the published bbox). `MB_CMD = 13` runs three synthetic known-answer
maps through the SHIPPED C: 3 of 3, and the case-3 feature vector matches the Python port
exactly. The test found and killed a design error: a rectangular notch has fill ratio 100%,
so "low fill = notch" was wrong; the table now keys on attachment to the part outline.

**No classification accuracy is claimed** — the operator's ~40 damaged boards are the only
way to measure it, and the exact protocol is item 1 of the Stage 5 document.

## State of the bench, stated plainly

The scene was NOT still for parts of this session: the firmware's own gate declined 25..73
loops in several runs, and one acceptance attempt read 20 of 49 comparisons over the limit,
all in a box at the frame's LEFT EDGE (not the part). Two runs of this session (a Stage 2
drift and the Stage 5 verification) also show the transform at −0.04..−0.30 deg with dx 0.75..4
px, held (mode 2), which is what produces the 14..64-cell readings when no fresh reference
has been taken. **Take a fresh reference (`MB_CMD = 9`) before quoting any cell count**, and
check `MB_AVG_SKIP` did not move during the run.

## The next thing to do, in order

1. **Five repeat runs at N = 8** (`xsdb ps_fft_dual/st2_accept_20261024.tcl X 115 8`) and count
   the runs where `MB_REG_MODE` leaves 2. If any drifts, the transform-dependent cell count
   must not be published as a verdict until the hold margins (`REG_WARM_MARGIN` 16,
   `REG_JUMP_MARGIN` 32) are re-derived against the AVERAGED lattice — they were measured
   against a single frame, whose noise floor is 1.6x higher.
2. **Make a drift visible as its own state.** The firmware already has state 3 UNSTABLE and
   the mode words; today a drift that the search keeps is indistinguishable from a good hold
   except by the cell count, which is the wrong instrument for it.
3. Then the Stage 4 local-threshold work, and only then any second colour statistic.

## Human-dependent experiments (exact wording for the operator)

1. **The damaged boards** (Stage 5 accuracy, the one claim this project makes that no session
   can measure): for each board take a reference (`MB_CMD = 9`), then read `MB_BLOB_CLASS`
   (462), the bbox (463..466), `MB_BLOB_TOUCH` (470), `MB_BLOB_HOLES` (471) and
   `MB_DIFF_CELLS` (181), and record the operator's own description of the damage. Confusion
   matrix from that; nothing else.
2. **A part moved 1-2 cm**, and **a part rotated 0.16 / 0.5 / 1.0 deg** — unchanged from the
   previous handover, and now they also test whether a drift is detected or adopted.
3. **The row band**: point the camera at a matte grey card, take a reference, read
   `MB_DIFF_ROW` (416..460) with the room lamp on and off. If the ±5-count sine disappears
   with the lamp it is flicker; if it stays it is the readout.
