www1453/trustscope/docs/MB_WORDS_20261025.md

# Mailbox word map -- rebuilt from the source, 2026-10-25

Generated by `python dl/mb_words.py --write dl/MB_WORDS_20261025.md`,
which parses every `#define MB_<NAME> <int>` out of `ps_ui/main.c`.
The mailbox base is `MAILBOX 0x10F00000` (`ps_ui/main.c:277`), byte offset = **index x 4**.

**Why this file exists.** The previous session's host scripts read words
366/368/494/496 and got nonsense (17826237). A word number in a note is a
claim; the defines in `main.c` are the authority. Every read below was done
through this table, and the guard `dl/mb_rd.py` refuses an index that is not
in it.

## Summary

| item | value |
|---|---|
| MB_* defines parsed as words | 352 |
| distinct names | 351 |
| distinct indices | 351 |
| indices carrying two DIFFERENT names (must be 0) | 0 |
| MB_* defines that are NOT plain integers | 0 |
| MB_* defines that are magic values, not word indices | 2 |
| "byte N" comments where N != 4 x index (must be 0) | 0 |
| index range | 0 .. 511 (mailbox is 512 words) |

## Magic values, NOT word indices (do not use these as addresses)

- `MB_P1_OK` = 0xA1C0A1C0 (main.c:10926) 
- `MB_VALID` = 0x54534331 (main.c:11046) "TSC1"

Self-check passed: every "byte N" comment in the map equals 4 x its index,
i.e. the comments agree with the indices without being asked to.

## The words this task touches

| word | name | main.c | meaning |
|---|---|---|---|
| 145 | `MB_AEC_EXP` | 1476 | byte 580: exposure the controller asks for, lines |
| 149 | `MB_AEC_GAIN` | 1477 | byte 596: the 8-bit gain it asks for |
| 144 | `MB_AEC_STATE` | 1475 | byte 576: 0 idle 1 converged 2 adjusting 3 stuck |
| 154 | `MB_AEC_LAST` | 1498 | byte 616: decision code of the last evaluation |
| 151 | `MB_AEC_MEAN` | 1478 | byte 604: camera-frame green mean, per-mille of 255 |
| 224 | `MB_READY` | 2665 | byte 896: 1 = settled enough to judge |
| 503 | `MB_FRAME_TICKS` | 2534 | byte 2012: measured capture store period, ticks |
| 504 | `MB_LINE_PS` | 2535 | byte 2016: derived line period, picoseconds |
| 509 | `MB_LINE10` | 2537 | byte 2036: lines per 10 ms, 1/16 line (quantum) |
| 508 | `MB_EXP_LOCK` | 2536 | byte 2032: HOST: locked exposure, 1/16 line |
| 511 | `MB_SEN_SIZE` | 2539 | byte 2044: (VTS<<16)/HTS as read back |
| 510 | `MB_SEN_TIMING` | 2538 | byte 2040: PLL35/36/37 + 0x3824 as read back |
| -- | `MB_KM_MAX` | -- | **NOT PRESENT IN SOURCE** |
| -- | `MB_MASK_PTS` | -- | **NOT PRESENT IN SOURCE** |
| 394 | `MB_REG_INCERR` | 2090 | the held answer's error on this frame, 1/16 |

## Full table (sorted by index)

| index | name | main.c | meaning (trailing comment in source) |
|---|---|---|---|
| 0 | `MB_MAGIC` | 10804 |  |
| 1 | `MB_SEQ` | 10805 |  |
| 2 | `MB_VERDICT` | 10806 |  |
| 3 | `MB_TOTAL` | 10807 |  |
| 4 | `MB_OK` | 10808 |  |
| 5 | `MB_NG` | 10809 |  |
| 6 | `MB_UNSURE` | 10810 |  |
| 7 | `MB_FPSX10` | 10811 |  |
| 8 | `MB_SCORE` | 10812 |  |
| 9 | `MB_ALARM` | 10813 |  |
| 10 | `MB_PS_FRAMES` | 10817 |  |
| 11 | `MB_PROGRESS` | 10830 |  |
| 12 | `MB_FAULT` | 111 | mailbox offset 48, PS-owned |
| 13 | `MB_TOL_N` | 2457 | good units whose amplitudes the map holds |
| 14 | `MB_TOL_VAR` | 2458 | cells the map relaxed above the floor (tol > 30 grey) |
| 15 | `MB_TOL_MAX` | 2459 | the largest tolerance in the map, grey |
| 16 | `MB_TOL_AT` | 2460 | (gy<<8)/gx of that cell, in BASELINE 8x8 cells |
| 17 | `MB_TOL_USED` | 2461 | per comparison: 1 = judged against the map, 0 = fixed 30 |
| 18 | `MB_SCTLR` | 10844 |  |
| 19 | `MB_CAMID` | 10852 |  |
| 20 | `MB_FRAME_R0` | 165 | offset 80 |
| 21 | `MB_PART_RAW` | 2367 | mask cells BEFORE the cluster rule (the old rule) |
| 22 | `MB_DIFF_DN` | 2368 | deep cells this frame: /d/ > MB_DIFF_DAMPTHR |
| 23 | `MB_DIFF_DAREA` | 2369 | THE AUTHORITY: largest connected deep group, cells |
| 24 | `MB_DIFF_DAMP` | 2370 | largest /d/ inside that group, grey counts |
| 25 | `MB_DIFF_DAT` | 2371 | (gy<<8)/gx of that cell, 8x8 units |
| 26 | `MB_DIFF_DBX0` | 2372 | bbox of that group, 8x8 cells (x8 = source px) |
| 27 | `MB_DIFF_DBY0` | 2373 |  |
| 28 | `MB_DIFF_DBX1` | 2374 |  |
| 29 | `MB_DIFF_DBY1` | 2375 |  |
| 30 | `MB_DIFF_DAMPTHR` | 2376 | the amplitude threshold the group rule used, grey |
| 31 | `MB_DIFF_DAREAMIN` | 2377 | the minimum area it requires, cells (mirrors LIM) |
| 32 | `MB_DIFF_DLIM_USED` | 2378 | the area limit actually applied (LIM resolved) |
| 33 | `MB_PART_GREEN` | 2401 | OLD rule: green dominance, eroded, BEFORE the cluster |
| 34 | `MB_PART_GCLU` | 2402 | OLD rule: the same after the cluster rule (old PTS) |
| 35 | `MB_PART_RULE` | 2403 | which rule built THIS live mask: 0 green, 1 background |
| 36 | `MB_PART_RRULE` | 2404 | which rule built the BASELINE mask, at the last ref |
| 37 | `MB_PART_BGWHY` | 2405 | why the background rule did not run: 0 ran, 1 no |
| 38 | `MB_BG_AGE` | 2407 | comparisons since the background was captured/adopted |
| 39 | `MB_BG_MEDD` | 2408 | median /live*scale - background/, grey (health of it) |
| 40 | `MB_TOL_MIN` | 2462 | HOST: samples needed before the map judges (0 = 3) |
| 41 | `MB_DIFF_DVAR` | 2463 | per comparison: cells over their OWN tolerance |
| 42 | `MB_DIFF_DRESQ` | 2464 | per comparison: cells the map RESCUED (tol>30, 30</d/<=tol) |
| 43 | `MB_TOL_JUMP` | 2467 | cells that went up at the LAST learn (audit of a step) |
| 44 | `MB_TOL_EPOCH` | 2468 | MAP GENERATION: +1 at every reference taken and at every |
| 45 | `MB_TOL_SCALE` | 2477 | HOST: the learned envelope's weight, 1/256 (256 = as |
| 46 | `MB_I2C_OK` | 10853 |  |
| 47 | `MB_I2C_ERR` | 10854 |  |
| 48 | `MB_MEAN_A` | 10866 |  |
| 49 | `MB_MEAN_B` | 10867 |  |
| 50 | `MB_PAIR_RATIO` | 10868 |  |
| 51 | `MB_PAIR` | 10869 |  |
| 52 | `MB_PHASE` | 10870 |  |
| 53 | `MB_FPTR` | 10871 |  |
| 54 | `MB_CLIPLONG` | 1435 | byte 216: channels >= FUSE_CLIP, long only |
| 55 | `MB_RECOVER` | 1436 | byte 220: of those, brought under 256 |
| 56 | `MB_CHANTOT` | 1437 | byte 224: channels examined (691200/frame) |
| 57 | `MB_LONGISB` | 1438 | byte 228: 1 if store B holds the long exp |
| 58 | `MB_BRACKET` | 1439 | byte 232: HOST-written boot MODE selector |
| 59 | `MB_BRIGHT_A` | 1440 | byte 236: bright samples in CAM_BUF |
| 60 | `MB_BRIGHT_B` | 1441 | byte 240: bright samples in CAM_BUF_B |
| 61 | `MB_CLIP_PM` | 1446 | byte 244: clipped channels per 1000 |
| 62 | `MB_BB_X0` | 1447 | byte 248: saturated bbox, in UI camera px |
| 63 | `MB_BB_Y0` | 1448 | byte 252 |
| 64 | `MB_BB_X1` | 1449 | byte 256 |
| 65 | `MB_BB_Y1` | 1450 | byte 260 |
| 66 | `MB_CLIP_GATE` | 1451 | byte 264: 1 = saturation gate tripped |
| 67 | `MB_CLIP_LIM` | 1452 | byte 268: HOST-set limit, per 1000 (0=def) |
| 68 | `MB_CLIP_LIME` | 1453 | byte 272: the limit the PS ACTUALLY used |
| 69 | `MB_PART_INVIEW` | 2802 | byte 276: 1 = part visible AND fully inside the frame |
| 70 | `MB_T_SYNC` | 8588 | byte 280: wait for capture handover |
| 71 | `MB_T_CLASS` | 8589 | byte 284: publish + invalidate + classify |
| 72 | `MB_T_QUAL` | 8590 | byte 288: measure() -- the quality metric |
| 73 | `MB_T_CAM` | 8591 | byte 292: draw_camera (incl. clip box) |
| 74 | `MB_T_PANEL` | 8592 | byte 296: draw_panel |
| 75 | `MB_T_TAIL` | 8593 | byte 300: draw_bottom + clean + park flip |
| 76 | `MB_T_TOTAL` | 8594 | byte 304: whole loop |
| 77 | `MB_TIMER_OK` | 8595 | byte 308: 1 = the timer was SEEN counting |
| 78 | `MB_T_PUB` | 8596 | byte 312: after the flip: mailbox + counters |
| 79 | `MB_T_N` | 8597 | byte 316: how many loops these sums cover |
| 80 | `MB_P1_A0` | 10920 | byte 320: first word of camera 1 store A |
| 81 | `MB_P1_AM` | 10921 | byte 324: last word of camera 1 store A |
| 82 | `MB_P1_B0` | 10922 | byte 328: first word of camera 1 store B |
| 83 | `MB_P1_BM` | 10923 | byte 332: last word of camera 1 store B |
| 84 | `MB_P1_CTL` | 10924 | byte 336: camera 0 store A word 0 (CONTROL) |
| 85 | `MB_P1_DONE` | 10925 | byte 340: 0xA1C0A1C0 once every read returned |
| 86 | `MB_VIEW` | 10935 | byte 344: DISPLAY MODE, 0 = full frame, 1 = part crop. |
| 87 | `MB_TOUCH_OK` | 10938 | byte 348: 1 = the GT911 identified itself (id 911) |
| 88 | `MB_TOUCH_EV` | 10939 | byte 352: touch event count |
| 89 | `MB_TOUCH_ERR` | 10940 | byte 356: I2C transfer failures in the touch path |
| 90 | `MB_TOUCH_ST` | 10941 | byte 360: last raw status byte from 0x814E |
| 91 | `MB_TOUCH_PID` | 10942 | byte 364: the 4 product-id bytes (0x39 0x31 0x31 0x00) |
| 92 | `MB_TOUCH_X` | 10943 | byte 368: last touch x (panel pixels) |
| 93 | `MB_TOUCH_Y` | 10944 | byte 372: last touch y |
| 94 | `MB_TAP` | 10945 | byte 376: rising-edge taps seen since boot |
| 95 | `MB_THUMB_N` | 10949 | byte 380: thumbnail-pair counter |
| 96 | `MB_BLINK` | 10957 | byte 384: current alarm-blink phase, 0/1 |
| 97 | `MB_TEAR` | 10968 | byte 388: renders during which the capture flipped |
| 98 | `MB_TEAR_N` | 10969 | byte 392: renders counted (the denominator) |
| 99 | `MB_CAP_TRANS` | 10970 | byte 396: capture-pointer transitions seen |
| 100 | `MB_CAP_SAMP` | 10971 | byte 400: samples taken while counting them |
| 101 | `MB_CMD` | 10976 | byte 404: host -> PS command word (1 = rate probe, 2 = bench, 3 = busy loop) |
| 102 | `MB_B_N` | 11026 | byte 408: iterations per loop in the benchmark |
| 103 | `MB_B_ALU` | 11027 | byte 412: ticks for the register-only loop |
| 104 | `MB_B_CODE` | 11028 | byte 416: ticks for the call-per-iteration loop |
| 105 | `MB_B_DDR` | 11029 | byte 420: ticks for the DDR-word loop |
| 106 | `MB_B_PL` | 11030 | byte 424: ticks for the PL-register loop |
| 107 | `MB_B_SAME` | 11043 | byte 428: ticks for the same-word loop |
| 108 | `MB_B_OCM` | 11044 | byte 432: ticks for the on-chip SRAM loop |
| 109 | `MB_BUSY_N` | 10990 | byte 436: iterations of the busy loop (fixed) |
| 110 | `MB_BUSY_TICKS` | 10991 | byte 440: its own tick count, for comparison |
| 111 | `MB_CAM1_TEAR` | 10997 | byte 444: copies whose source wrapped underneath |
| 112 | `MB_CAM1_TEAR_N` | 10998 | byte 448: copies taken |
| 113 | `MB_CAM1_STORE` | 10999 | byte 452: 0/1 = store the LIVE measurement read |
| 114 | `MB_CAM1_FP` | 11000 | byte 456: camera 1 frame index, field CAP_FRPTR[14:9] |
| 115 | `MB_PART_BX0` | 2797 | byte 460: live mask bbox, min column, lattice cells |
| 116 | `MB_PART_BY0` | 2798 | byte 464: live mask bbox, min row, lattice cells |
| 117 | `MB_CAM1_US` | 11001 | byte 468: how long the CAM1 copy takes, microsec |
| 118 | `MB_CAM1_FPSA` | 11002 | byte 472: camera 1: CAM1_BUF row361 changes/s |
| 119 | `MB_CAM1_FPSB` | 11003 | byte 476: camera 1: CAM1_BUF_B row361 changes/s |
| 120 | `MB_CAM1_PUS` | 11004 | byte 480: length of that probe window, microsec |
| 121 | `MB_CAM1_WAIT` | 11012 | byte 484: unused by the live path (the old wait wrote it); MB_CAM1_PTR_BAD is the current indicator |
| 122 | `MB_PS_FPSX10` | 10818 | MOVED off word 11: it collided with MB_PROGRESS |
| 123 | `MB_ARM_N` | 10881 | byte 492: arms since reset |
| 124 | `MB_CNN_OK` | 11005 | byte 496: 1 = cnn_init() read its ARG registers back |
| 125 | `MB_CNN_PASS` | 11006 | byte 500: known-answer vectors that matched csim |
| 126 | `MB_CNN_RUNS` | 11007 | byte 504: per-frame inferences attempted |
| 127 | `MB_CNN_L0` | 11008 | byte 508: logit 0 of the last inference |
| 128 | `MB_CNN_L1` | 11009 | byte 512: logit 1 |
| 129 | `MB_CNN_CLS` | 11010 | byte 516: 0 or 1, the larger logit |
| 130 | `MB_CNN_CYC` | 11011 | byte 520: cycles the last inference took |
| 131 | `MB_ARM_DT` | 10877 | byte 524: ticks between the last two arms (0 = first) |
| 132 | `MB_ARM_EXP` | 10878 | byte 528: exposure written to camera 0 at the last arm |
| 133 | `MB_ARM_PHASE` | 10879 | byte 532: phase armed at the last arm |
| 134 | `MB_LASTDONE` | 10880 | byte 536: 1 = CAM_BUF_B held the frame just completed |
| 135 | `MB_FOCUS` | 110 | byte 540: mean /dL/dx/ x10, a focus aid |
| 136 | `MB_PART_BX1` | 2799 | byte 544: live mask bbox, max column, lattice cells |
| 137 | `MB_PAIR_N` | 10882 | byte 548: frames with a valid pair since reset |
| 138 | `MB_MEAN_RENDER` | 10889 | byte 552: green mean of the store being rendered |
| 139 | `MB_LONG_EXP` | 10895 | byte 556: long arm, lines (0 = CAM_LONG_L) |
| 140 | `MB_SHORT_EXP` | 10896 | byte 560: short arm, lines (0 = CAM_SHORT_L) |
| 141 | `MB_VTS_FIX` | 10899 | byte 564: repairs made by the VTS self-healing check |
| 142 | `MB_ARM_LOST` | 10897 | arms whose read-back did not match what was written |
| 143 | `MB_ARM_UNREAD` | 10898 | arms whose read-back did not answer |
| 144 | `MB_AEC_STATE` | 1475 | byte 576: 0 idle 1 converged 2 adjusting 3 stuck |
| 145 | `MB_AEC_EXP` | 1476 | byte 580: exposure the controller asks for, lines |
| 146 | `MB_VTC_ECHO` | 85 |  |
| 147 | `MB_ZOOM` | 87 | byte 588: THE OPERATOR'S ZOOM: 0 = full view, 1 = SHOW ONLY |
| 148 | `MB_EDGES` | 86 | byte 592: count of strong-edge samples, see measure() |
| 149 | `MB_AEC_GAIN` | 1477 | byte 596: the 8-bit gain it asks for |
| 150 | `MB_LOCAL_VERDICT` | 1604 | byte 600: 0 OK 1 NG 2 UNKNOWN |
| 151 | `MB_AEC_MEAN` | 1478 | byte 604: camera-frame green mean, per-mille of 255 |
| 152 | `MB_AEC_STEPS` | 1479 | byte 608: adjustments made since reset |
| 153 | `MB_AEC_EVAL` | 1480 | byte 612: evaluations made -- proves it is running |
| 154 | `MB_AEC_LAST` | 1498 | byte 616: decision code of the last evaluation |
| 155 | `MB_AEC_EVCLIP` | 1499 | byte 620: g_clip_pm AT that evaluation |
| 156 | `MB_AEC_EVMEAN` | 1500 | byte 624: mean_pm AT that evaluation |
| 157 | `MB_AEC_MASK` | 1515 | byte 628: mask points the decision used (g_part_pts) |
| 158 | `MB_AEC_K` | 1516 | byte 632: whole 10 ms periods the controller is on |
| 159 | `MB_AEC_FLAGS` | 1517 | byte 636: bit0 host pinned, bit1 mask short, |
| 164 | `MB_AEC_TRIES` | 1527 | byte 656: consecutive lever moves that did not help |
| 165 | `MB_SEN_VTS` | 1528 | byte 660: VTS this build wrote / reads back |
| 166 | `MB_PART_BY1` | 2800 | byte 664: live mask bbox, max row, lattice cells |
| 167 | `MB_PART_EDGE` | 2801 | byte 668: min border clearance, cells; 1 = at the edge |
| 168 | `MB_FWID0` | 1610 | byte 672: 'TSC1' as four bytes |
| 169 | `MB_FWID1` | 1611 | byte 676: source hash chars 0..3 |
| 170 | `MB_FWID2` | 1612 | byte 680: source hash chars 4..7 |
| 171 | `MB_FWID3` | 1613 | byte 684: zero padding |
| 172 | `MB_CAP_G1` | 2827 |  |
| 173 | `MB_CAP_PAIRS` | 2828 |  |
| 174 | `MB_CAP_DEC` | 2829 |  |
| 175 | `MB_CAP_DECN` | 2830 |  |
| 176 | `MB_CAP_WAITN` | 2831 |  |
| 177 | `MB_CAP_WORD` | 2832 |  |
| 178 | `MB_CAP_MSB` | 244 |  |
| 179 | `MB_REG_RULE` | 2158 | mask rule the last search scored with (see above) |
| 180 | `MB_DIFF_OK` | 2159 | byte 720: 1 = a reference frame is captured |
| 181 | `MB_DIFF_CELLS` | 2160 | byte 724: whole-frame coarse cells, DIAGNOSTIC ONLY: |
| 182 | `MB_DIFF_X0` | 2167 | byte 728: bbox in GRID units (x8 = source px) |
| 183 | `MB_DIFF_Y0` | 2168 | byte 732 |
| 184 | `MB_DIFF_X1` | 2169 | byte 736 |
| 185 | `MB_DIFF_Y1` | 2170 | byte 740 |
| 186 | `MB_DIFF_MS` | 2171 | byte 744: ticks the last comparison took |
| 187 | `MB_DIFF_REFEXP` | 2172 | byte 748: exposure when the reference was taken |
| 188 | `MB_DIFF_REFGAIN` | 2173 | byte 752: gain when the reference was taken |
| 189 | `MB_DIFF_N` | 2174 | byte 756: comparisons taken |
| 190 | `MB_DIFF_BIAS` | 2175 | byte 760: mean signed cell difference, +512 offset |
| 191 | `MB_DIFF_RSTATE` | 2178 | byte 764 |
| 192 | `MB_DIFF_RPX` | 2179 | byte 768: differing pixels at full resolution |
| 193 | `MB_DIFF_RX0` | 2180 | byte 772: tight bbox in SOURCE pixels |
| 194 | `MB_DIFF_RY0` | 2181 | byte 776 |
| 195 | `MB_DIFF_RX1` | 2182 | byte 780 |
| 196 | `MB_DIFF_RY1` | 2183 | byte 784 |
| 197 | `MB_DIFF_RMS` | 2184 | byte 788: ticks the refinement took |
| 198 | `MB_DIFF_HITS` | 2186 | byte 792: best consecutive-hit count this frame |
| 199 | `MB_SETTLE_MOTION` | 2195 | byte 796: cells that changed shape since last loop |
| 200 | `MB_DIFF_SCALE` | 2199 | byte 800: gain applied, 256 = 1.0 |
| 201 | `MB_DIFF_DX` | 2210 | byte 804: shift found, 1/16 source px (signed) |
| 202 | `MB_DIFF_DY` | 2211 | byte 808: same in y |
| 203 | `MB_DIFF_SAD` | 2212 | byte 812: match error at that shift, 1/16 gm unit |
| 204 | `MB_CAM0_VERDICT` | 1548 | 0 PASS 1 NG 2 CANNOT JUDGE, camera 0 alone |
| 205 | `MB_CAM1_VERDICT` | 1549 | same encoding, camera 1 alone |
| 206 | `MB_CAM1_PTR_BAD` | 1550 | 1 = pointer stale, previous store measured |
| 207 | `MB_CAM1_AEC_STATE` | 1551 | 0 idle 1 converged 2 adjusting 3 stuck |
| 208 | `MB_CAM1_AEC_EXP` | 1552 | exposure camera 1's controller asks for |
| 209 | `MB_CAM1_AEC_GAIN` | 1553 | gain camera 1's controller asks for |
| 210 | `MB_CAM1_MEAN` | 1554 | camera 1 green mean, per-mille of 255 |
| 211 | `MB_CAM1_CLIP` | 1555 | camera 1 clipped channels per 1000 |
| 212 | `MB_CAM0_MEAN` | 1556 | camera 0 via measure_pass, per-mille |
| 213 | `MB_CAM0_CLIP` | 1557 | camera 0 via measure_pass, per 1000 |
| 214 | `MB_CAM1_AEC_STEPS` | 1558 | adjustments camera 1's loop has made |
| 215 | `MB_CAM1_AEC_EVAL` | 1559 | evaluations -- proves camera 1's loop runs |
| 216 | `MB_CAM1_AEC_LAST` | 1560 | decision code of the last evaluation |
| 217 | `MB_CAM1_AEC_EVCLIP` | 1561 | camera 1 clip_pm at that evaluation |
| 218 | `MB_CAM1_AEC_EVMEAN` | 1562 | camera 1 mean_pm at that evaluation |
| 219 | `MB_FP_INVERT` | 278 | 1 = read the store ABOUT to be written: the |
| 219 | `MB_FP_INVERT` | 1571 | host: 1 = invert the capture-store selection polarity |
| 220 | `MB_DIFF_LIM` | 1595 | host: FIRST cell count that fails; 0 = default (8) |
| 221 | `MB_DIFF_ARM` | 1596 | host: 1 = the diff arm votes on MB_LOCAL_VERDICT |
| 222 | `MB_DIFF_VERDICT` | 1597 | 0 pass / 1 NG / 2 cannot judge, from the diff arm |
| 223 | `MB_DIFF_LIM_USED` | 1598 | the limit actually applied (default resolved) |
| 224 | `MB_READY` | 2665 | byte 896: 1 = settled enough to judge |
| 225 | `MB_SETTLE_MS` | 2666 | byte 900: ms the settling episode has taken |
| 226 | `MB_ALIGN_DX` | 6546 | byte 904: shift found, 1/16 source px (signed) |
| 227 | `MB_ALIGN_DY` | 6547 | byte 908: same in y |
| 228 | `MB_REBASE_REQ` | 2908 | 1 = the compensation is out of bounds: retake the baseline |
| 229 | `MB_BG_CELLS` | 6554 | byte 916: cells over threshold vs the background |
| 230 | `MB_BG_STATE` | 6553 | byte 920: background capture state |
| 231 | `MB_REG_SCALE` | 2039 | geometric scale, 1/256 units (256 = unchanged) |
| 232 | `MB_REG_STATE` | 2040 | 0 = no baseline, 1 = registered, 2 = CANNOT JUDGE |
| 233 | `MB_REG_TICKS` | 2041 | ticks the last search took; /334800 = ms |
| 234 | `MB_REG_WWHY` | 2142 |  |
| 235 | `MB_REG_WDX` | 2143 |  |
| 236 | `MB_REG_WDY` | 2144 |  |
| 237 | `MB_REG_WTH` | 2145 |  |
| 238 | `MB_REG_WSC` | 2146 |  |
| 239 | `MB_REG_WERR` | 2147 |  |
| 240 | `MB_SETTLE_ROWM` | 2734 | base: 34 rows, 240..273, 1/16 count, signed |
| 274 | `MB_SETTLE_ROWC` | 2735 | base: 34 rows, 274..307, cells over threshold |
| 308 | `MB_READY_STILL` | 2736 | byte 1232: consecutive still loops |
| 309 | `MB_GATE_AECOK` | 2737 | byte 1236: gate loops with camera-0 AEC state 1 |
| 310 | `MB_GATE_LOOPS` | 2738 | byte 1240: gate loops evaluated |
| 311 | `MB_GATE_READY` | 2739 | byte 1244: gate loops that came out ready |
| 312 | `MB_GATE_FLIPS` | 2740 | byte 1248: AEC state changes the gate saw |
| 313 | `MB_GATE_HO` | 2741 | byte 1252: g_ho_n at the last evaluation |
| 314 | `MB_GATE_STILLN` | 2742 | byte 1256: loops whose motion was within the limit |
| 315 | `MB_SETTLE_HIST` | 2743 | base: 12 bins, 315..326, /change - bias/ |
| 327 | `MB_SETTLE_ABSSUM` | 2744 | byte 1308: sum /change - bias/ over decision cells |
| 328 | `MB_SETTLE_SQSUM` | 2745 | byte 1312: sum (change - bias)^2 over the same cells |
| 329 | `MB_SETTLE_MOTG` | 2746 | byte 1316: the OLD whole-frame count, same frames |
| 330 | `MB_GRID_ROWM` | 2747 | base: 36 rows, 330..365, current grid row mean x16 |
| 366 | `MB_PART_PTS` | 2754 | byte 1464: live mask points after erosion |
| 367 | `MB_PART_REF` | 2755 | byte 1468: baseline mask points after erosion |
| 368 | `MB_PART_USED` | 2756 | byte 1472: points the winning search scored |
| 369 | `MB_PART_MEDIAN` | 2760 | byte 1476: this frame's block-score median + 128 |
| 370 | `MB_PART_MARGIN` | 2761 | byte 1480: counts above that median the mask used |
| 371 | `MB_PART_MEDREF` | 2762 | byte 1484: the baseline's own median + 128 |
| 372 | `MB_CAP_WRIDX` | 2810 | byte 1488: capture write store index, 0..3 |
| 373 | `MB_CAP_RDIDX` | 2811 | byte 1492: store index the renderer read |
| 374 | `MB_CAP_PARITY` | 2812 | byte 1496: the hardware frame-pointer bit, sampled |
| 375 | `MB_CAP_CALIB` | 2833 | byte 1500: 0 not run, 1 index established, 2 not |
| 376 | `MB_CAP_PERIOD` | 2834 | byte 1504: measured handover interval, microseconds |
| 377 | `MB_CAP_LONG` | 2835 | byte 1508: sample intervals that could miss a flip |
| 378 | `MB_TEAR_SEL` | 2836 | byte 1512: renders whose SOURCE store was written |
| 379 | `MB_TEAR_SELN` | 2837 | byte 1516: renders counted (the denominator) |
| 380 | `MB_CAP_FIX` | 2838 | byte 1520: parity corrections the sampler had to make |
| 381 | `MB_TEAR_DMAX` | 2839 | byte 1524: biggest row-sum change across the render |
| 382 | `MB_TEAR_DROW` | 2840 | byte 1528: of 8 sampled rows, how many changed |
| 383 | `MB_TEAR_ROW` | 2841 | byte 1532: renders where a sampled row really changed |
| 384 | `MB_TEAR_ROWN` | 2842 | byte 1536: renders counted (the denominator) |
| 385 | `MB_REG_ANGLE` | 2057 | tenths of a degree, signed |
| 386 | `MB_REG_ANGLE100` | 2058 | hundredths of a degree, signed (audit word) |
| 387 | `MB_TEAR_BIG` | 2845 | renders with a row change above 100 counts (a rewrite |
| 388 | `MB_CAP_AGE` | 2847 | (write index - selected index) & 3 AT SELECTION: |
| 389 | `MB_TEAR_WIN` | 2855 | torn renders with >=1 handover inside the render |
| 390 | `MB_TEAR_NOFLIP` | 2856 | torn renders with NO handover inside the render |
| 391 | `MB_CAP_ELAPSED` | 2857 | microseconds between the last handover and the store |
| 392 | `MB_CAP_WAITS` | 2859 | renders whose selection had to wait for an edge |
| 393 | `MB_REG_MODE` | 2089 | how the last search answered (see above) |
| 394 | `MB_REG_INCERR` | 2090 | the held answer's error on this frame, 1/16 |
| 395 | `MB_REG_CANDERR` | 2091 | the losing candidate's error, 1/16 |
| 396 | `MB_REG_NWARM` | 2092 | answers taken from the local window |
| 397 | `MB_REG_NHOLD` | 2093 | answers kept from the held transform |
| 398 | `MB_REG_NCOLD` | 2094 | answers from a full search |
| 399 | `MB_REG_NUNST` | 2095 | frames published as UNSTABLE |
| 400 | `MB_CAP_DBG0` | 1264 | canary readback immediately after the write, store 0 |
| 401 | `MB_CAP_DBG1` | 1265 | ... store 1 |
| 402 | `MB_CAP_DBG2` | 1266 | ... store 2 |
| 403 | `MB_CAP_DBG3` | 1267 | ... store 3 |
| 404 | `MB_CAP_DBG4` | 1268 | trials run |
| 405 | `MB_CAP_DBG5` | 1269 | deaths seen in the last trial |
| 406 | `MB_CAP_DBG6` | 1270 | first index of the last trial (0xF = none) |
| 407 | `MB_CAP_DBG7` | 1271 | handovers observed during the warm-up |
| 408 | `MB_AVG_N` | 2260 | byte 1632: HOST: frames to average, 1 = off |
| 409 | `MB_AVG_CNT` | 2261 | byte 1636: frames the last comparison averaged |
| 410 | `MB_AVG_SKIP` | 2262 | byte 1640: loops declined, MB_READY was 0 |
| 411 | `MB_AVG_TICKS` | 2264 | byte 1644: ticks the last sampling pass took |
| 412 | `MB_DIFF_SIGMA` | 2265 | byte 1648: sigma of the cell difference, 1/16 lv |
| 413 | `MB_DIFF_OVER` | 2266 | byte 1652: cells over threshold before the rules |
| 414 | `MB_DIFF_MAXD` | 2267 | byte 1656: largest /difference/, grey counts |
| 415 | `MB_DIFF_AT` | 2268 | byte 1660: (gy<<8)/gx of that largest cell |
| 416 | `MB_DIFF_ROW` | 2277 | bytes 1664..1843: 45 row means, 1/16 grey level |
| 461 | `MB_AVG_TEAR` | 2263 | byte 1844: loops declined, the store was torn |
| 462 | `MB_BLOB_CLASS` | 2557 | byte 1848: the class of the largest blob |
| 463 | `MB_BLOB_X0` | 2558 | byte 1852: bbox in GRID units (x16 = source px) |
| 464 | `MB_BLOB_Y0` | 2559 | byte 1856 |
| 465 | `MB_BLOB_X1` | 2560 | byte 1860 |
| 466 | `MB_BLOB_Y1` | 2561 | byte 1864 |
| 467 | `MB_BLOB_AREA` | 2562 | byte 1868: cells in the blob |
| 468 | `MB_BLOB_FILL` | 2563 | byte 1872: percent, area / bbox area |
| 469 | `MB_BLOB_ASPECT` | 2564 | byte 1876: longer side / shorter side, x100 |
| 470 | `MB_BLOB_TOUCH` | 2565 | byte 1880: 0 interior 1 boundary 2 outside |
| 471 | `MB_BLOB_HOLES` | 2566 | byte 1884: enclosed background regions |
| 472 | `MB_BLOB_N` | 2567 | byte 1888: blobs found in the whole map |
| 473 | `MB_BLOB_CX` | 2568 | byte 1892: centroid x, 1/8 cell |
| 474 | `MB_BLOB_CY` | 2569 | byte 1896: centroid y, 1/8 cell |
| 475 | `MB_BLOB_TICKS` | 2570 | byte 1900: ticks the labelling and rules took |
| 476 | `MB_BLOB_ALL` | 2571 | byte 1904: bitmask of the classes present |
| 477 | `MB_BLOB_SELFTEST` | 2572 | byte 1908: (passed<<8)/run over 3 known answers |
| 478 | `MB_BLOB_ST` | 2573 | bytes 1912..1920: class each self-test case gave |
| 480 | `MB_PV_ON` | 96 | 1 = the part view is framed (0 = the full frame is drawn) |
| 481 | `MB_PV_OX` | 97 | source px of output pixel 0 (column origin) |
| 482 | `MB_PV_OY` | 98 | source px of output row 0 |
| 483 | `MB_PV_STEP` | 99 | Q16: source px per output px, both axes (aspect kept) |
| 484 | `MB_PV_BX0` | 100 | the mask bbox the framing was taken from, source px |
| 485 | `MB_PV_BY0` | 101 |  |
| 486 | `MB_PV_BX1` | 102 |  |
| 487 | `MB_PV_BY1` | 103 |  |
| 488 | `MB_PV_MIN` | 104 | HOST: mask points below this = no part, draw full frame |
| 489 | `MB_PV_N` | 105 | how many times the framing was (re)aimed -- a still scene |
| 490 | `MB_DIFF_DRAWN` | 109 | comparison cells the last diff-box render painted |
| 491 | `MB_REG_MOVE` | 2116 | last accepted transform's move, 1/100 of the bound |
| 492 | `MB_REG_NREAIM` | 2117 | cumulative re-aims |
| 493 | `MB_REG_GAIN` | 2127 | the adopted answer's gain over the held one |
| 494 | `MB_DIFF_FCELLS` | 2303 | byte 1976: fine cells after 3x3 + persistence |
| 495 | `MB_DIFF_FOVER` | 2304 | byte 1980: fine cells over, before those rules |
| 496 | `MB_DIFF_FVALID` | 2305 | byte 1984: fine cells judged (part + in bounds) |
| 497 | `MB_DIFF_FMAXD` | 2306 | byte 1988: largest /d/, grey counts |
| 498 | `MB_DIFF_FAT` | 2307 | byte 1992: (gy<<8)/gx of that cell, 8x8 units |
| 499 | `MB_DIFF_FX0` | 2308 | byte 1996: bbox of the surviving fine cells |
| 500 | `MB_DIFF_FY0` | 2309 |  |
| 501 | `MB_DIFF_FX1` | 2310 |  |
| 502 | `MB_DIFF_FY1` | 2311 |  |
| 503 | `MB_FRAME_TICKS` | 2534 | byte 2012: measured capture store period, ticks |
| 504 | `MB_LINE_PS` | 2535 | byte 2016: derived line period, picoseconds |
| 505 | `MB_INJ_CELL` | 2323 | byte 2020: HOST: (gy<<8)/gx of the stamp, 8x8 cells |
| 506 | `MB_INJ_PATCH` | 2324 | byte 2024: HOST: (size_px << 8) / amplitude |
| 507 | `MB_INJ_DONE` | 2325 | byte 2028: stamps applied since boot |
| 508 | `MB_EXP_LOCK` | 2536 | byte 2032: HOST: locked exposure, 1/16 line |
| 509 | `MB_LINE10` | 2537 | byte 2036: lines per 10 ms, 1/16 line (quantum) |
| 510 | `MB_SEN_TIMING` | 2538 | byte 2040: PLL35/36/37 + 0x3824 as read back |
| 511 | `MB_SEN_SIZE` | 2539 | byte 2044: (VTS<<16)/HTS as read back |
