www1453/trustscope/docs/MB_WORDS_20261026.md

# Mailbox word map -- rebuilt from the source, 2026-10-25

Generated by `python dl/mb_words.py --write dl/MB_WORDS_20261025.md`,
which parses every `#define MB_<NAME> <int>` out of `ps_ui/main.c`.
The mailbox base is `MAILBOX 0x10F00000` (`ps_ui/main.c:277`), byte offset = **index x 4**.

**Why this file exists.** The previous session's host scripts read words
366/368/494/496 and got nonsense (17826237). A word number in a note is a
claim; the defines in `main.c` are the authority. Every read below was done
through this table, and the guard `dl/mb_rd.py` refuses an index that is not
in it.

## Summary

| item | value |
|---|---|
| MB_* defines parsed as words | 367 |
| distinct names | 366 |
| distinct indices | 366 |
| indices carrying two DIFFERENT names (must be 0) | 0 |
| MB_* defines that are NOT plain integers | 0 |
| MB_* defines that are magic values, not word indices | 2 |
| "byte N" comments where N != 4 x index (must be 0) | 0 |
| index range | 0 .. 526 (WORD_LIMIT = 640; the mailbox REGION is 1 MB) |

## Magic values, NOT word indices (do not use these as addresses)

- `MB_P1_OK` = 0xA1C0A1C0 (main.c:11473) 
- `MB_VALID` = 0x54534331 (main.c:11593) "TSC1"

Self-check passed: every "byte N" comment in the map equals 4 x its index,
i.e. the comments agree with the indices without being asked to.

## The words this task touches

| word | name | main.c | meaning |
|---|---|---|---|
| 145 | `MB_AEC_EXP` | 1476 | byte 580: exposure the controller asks for, lines |
| 149 | `MB_AEC_GAIN` | 1477 | byte 596: the 8-bit gain it asks for |
| 144 | `MB_AEC_STATE` | 1475 | byte 576: 0 idle 1 converged 2 adjusting 3 stuck |
| 154 | `MB_AEC_LAST` | 1498 | byte 616: decision code of the last evaluation |
| 151 | `MB_AEC_MEAN` | 1478 | byte 604: camera-frame green mean, per-mille of 255 |
| 224 | `MB_READY` | 2665 | byte 896: 1 = settled enough to judge |
| 503 | `MB_FRAME_TICKS` | 2534 | byte 2012: measured capture store period, ticks |
| 504 | `MB_LINE_PS` | 2535 | byte 2016: derived line period, picoseconds |
| 509 | `MB_LINE10` | 2537 | byte 2036: lines per 10 ms, 1/16 line (quantum) |
| 508 | `MB_EXP_LOCK` | 2536 | byte 2032: HOST: locked exposure, 1/16 line |
| 511 | `MB_SEN_SIZE` | 2539 | byte 2044: (VTS<<16)/HTS as read back |
| 510 | `MB_SEN_TIMING` | 2538 | byte 2040: PLL35/36/37 + 0x3824 as read back |
| -- | `MB_KM_MAX` | -- | **NOT PRESENT IN SOURCE** |
| -- | `MB_MASK_PTS` | -- | **NOT PRESENT IN SOURCE** |
| 394 | `MB_REG_INCERR` | 2090 | the held answer's error on this frame, 1/16 |

## Full table (sorted by index)

| index | name | main.c | meaning (trailing comment in source) |
|---|---|---|---|
| 0 | `MB_MAGIC` | 11351 |  |
| 1 | `MB_SEQ` | 11352 |  |
| 2 | `MB_VERDICT` | 11353 |  |
| 3 | `MB_TOTAL` | 11354 |  |
| 4 | `MB_OK` | 11355 |  |
| 5 | `MB_NG` | 11356 |  |
| 6 | `MB_UNSURE` | 11357 |  |
| 7 | `MB_FPSX10` | 11358 |  |
| 8 | `MB_SCORE` | 11359 |  |
| 9 | `MB_ALARM` | 11360 |  |
| 10 | `MB_PS_FRAMES` | 11364 |  |
| 11 | `MB_PROGRESS` | 11377 |  |
| 12 | `MB_FAULT` | 111 | mailbox offset 48, PS-owned |
| 13 | `MB_TOL_N` | 2457 | good units whose amplitudes the map holds |
| 14 | `MB_TOL_VAR` | 2458 | cells the map relaxed above the floor (tol > 30 grey) |
| 15 | `MB_TOL_MAX` | 2459 | the largest tolerance in the map, grey |
| 16 | `MB_TOL_AT` | 2460 | (gy<<8)/gx of that cell, in BASELINE 8x8 cells |
| 17 | `MB_TOL_USED` | 2461 | per comparison: 1 = judged against the map, 0 = fixed 30 |
| 18 | `MB_SCTLR` | 11391 |  |
| 19 | `MB_CAMID` | 11399 |  |
| 20 | `MB_FRAME_R0` | 165 | offset 80 |
| 21 | `MB_PART_RAW` | 2367 | mask cells BEFORE the cluster rule (the old rule) |
| 22 | `MB_DIFF_DN` | 2368 | deep cells this frame: /d/ > MB_DIFF_DAMPTHR |
| 23 | `MB_DIFF_DAREA` | 2369 | THE AUTHORITY: largest connected deep group, cells |
| 24 | `MB_DIFF_DAMP` | 2370 | largest /d/ inside that group, grey counts |
| 25 | `MB_DIFF_DAT` | 2371 | (gy<<8)/gx of that cell, 8x8 units |
| 26 | `MB_DIFF_DBX0` | 2372 | bbox of that group, 8x8 cells (x8 = source px) |
| 27 | `MB_DIFF_DBY0` | 2373 |  |
| 28 | `MB_DIFF_DBX1` | 2374 |  |
| 29 | `MB_DIFF_DBY1` | 2375 |  |
| 30 | `MB_DIFF_DAMPTHR` | 2376 | the amplitude threshold the group rule used, grey |
| 31 | `MB_DIFF_DAREAMIN` | 2377 | the minimum area it requires, cells (mirrors LIM) |
| 32 | `MB_DIFF_DLIM_USED` | 2378 | the area limit actually applied (LIM resolved) |
| 33 | `MB_PART_GREEN` | 2401 | OLD rule: green dominance, eroded, BEFORE the cluster |
| 34 | `MB_PART_GCLU` | 2402 | OLD rule: the same after the cluster rule (old PTS) |
| 35 | `MB_PART_RULE` | 2403 | which rule built THIS live mask: 0 green, 1 background |
| 36 | `MB_PART_RRULE` | 2404 | which rule built the BASELINE mask, at the last ref |
| 37 | `MB_PART_BGWHY` | 2405 | why the background rule did not run: 0 ran, 1 no |
| 38 | `MB_BG_AGE` | 2407 | comparisons since the background was captured/adopted |
| 39 | `MB_BG_MEDD` | 2408 | median /live*scale - background/, grey (health of it) |
| 40 | `MB_TOL_MIN` | 2462 | HOST: samples needed before the map judges (0 = 3) |
| 41 | `MB_DIFF_DVAR` | 2463 | per comparison: cells over their OWN tolerance |
| 42 | `MB_DIFF_DRESQ` | 2464 | per comparison: cells the map RESCUED (tol>30, 30</d/<=tol) |
| 43 | `MB_TOL_JUMP` | 2467 | cells that went up at the LAST learn (audit of a step) |
| 44 | `MB_TOL_EPOCH` | 2468 | MAP GENERATION: +1 at every reference taken and at every |
| 45 | `MB_TOL_SCALE` | 2477 | HOST: the learned envelope's weight, 1/256 (256 = as |
| 46 | `MB_I2C_OK` | 11400 |  |
| 47 | `MB_I2C_ERR` | 11401 |  |
| 48 | `MB_MEAN_A` | 11413 |  |
| 49 | `MB_MEAN_B` | 11414 |  |
| 50 | `MB_PAIR_RATIO` | 11415 |  |
| 51 | `MB_PAIR` | 11416 |  |
| 52 | `MB_PHASE` | 11417 |  |
| 53 | `MB_FPTR` | 11418 |  |
| 54 | `MB_CLIPLONG` | 1435 | byte 216: channels >= FUSE_CLIP, long only |
| 55 | `MB_RECOVER` | 1436 | byte 220: of those, brought under 256 |
| 56 | `MB_CHANTOT` | 1437 | byte 224: channels examined (691200/frame) |
| 57 | `MB_LONGISB` | 1438 | byte 228: 1 if store B holds the long exp |
| 58 | `MB_BRACKET` | 1439 | byte 232: HOST-written boot MODE selector |
| 59 | `MB_BRIGHT_A` | 1440 | byte 236: bright samples in CAM_BUF |
| 60 | `MB_BRIGHT_B` | 1441 | byte 240: bright samples in CAM_BUF_B |
| 61 | `MB_CLIP_PM` | 1446 | byte 244: clipped channels per 1000 |
| 62 | `MB_BB_X0` | 1447 | byte 248: saturated bbox, in UI camera px |
| 63 | `MB_BB_Y0` | 1448 | byte 252 |
| 64 | `MB_BB_X1` | 1449 | byte 256 |
| 65 | `MB_BB_Y1` | 1450 | byte 260 |
| 66 | `MB_CLIP_GATE` | 1451 | byte 264: 1 = saturation gate tripped |
| 67 | `MB_CLIP_LIM` | 1452 | byte 268: HOST-set limit, per 1000 (0=def) |
| 68 | `MB_CLIP_LIME` | 1453 | byte 272: the limit the PS ACTUALLY used |
| 69 | `MB_PART_INVIEW` | 2802 | byte 276: 1 = part visible AND fully inside the frame |
| 70 | `MB_T_SYNC` | 9135 | byte 280: wait for capture handover |
| 71 | `MB_T_CLASS` | 9136 | byte 284: publish + invalidate + classify |
| 72 | `MB_T_QUAL` | 9137 | byte 288: measure() -- the quality metric |
| 73 | `MB_T_CAM` | 9138 | byte 292: draw_camera (incl. clip box) |
| 74 | `MB_T_PANEL` | 9139 | byte 296: draw_panel |
| 75 | `MB_T_TAIL` | 9140 | byte 300: draw_bottom + clean + park flip |
| 76 | `MB_T_TOTAL` | 9141 | byte 304: whole loop |
| 77 | `MB_TIMER_OK` | 9142 | byte 308: 1 = the timer was SEEN counting |
| 78 | `MB_T_PUB` | 9143 | byte 312: after the flip: mailbox + counters |
| 79 | `MB_T_N` | 9144 | byte 316: how many loops these sums cover |
| 80 | `MB_P1_A0` | 11467 | byte 320: first word of camera 1 store A |
| 81 | `MB_P1_AM` | 11468 | byte 324: last word of camera 1 store A |
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
