www1453/trustscope/figures/fig1_architecture.png

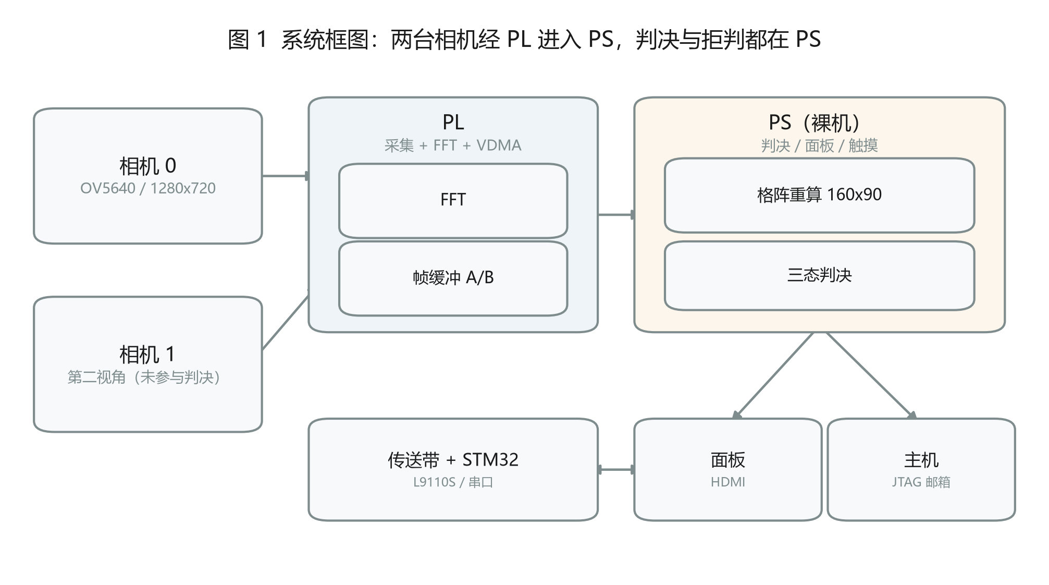
figures/fig1_architecture.png
