www1453/trustscope/figures/fig2_dataflow.png

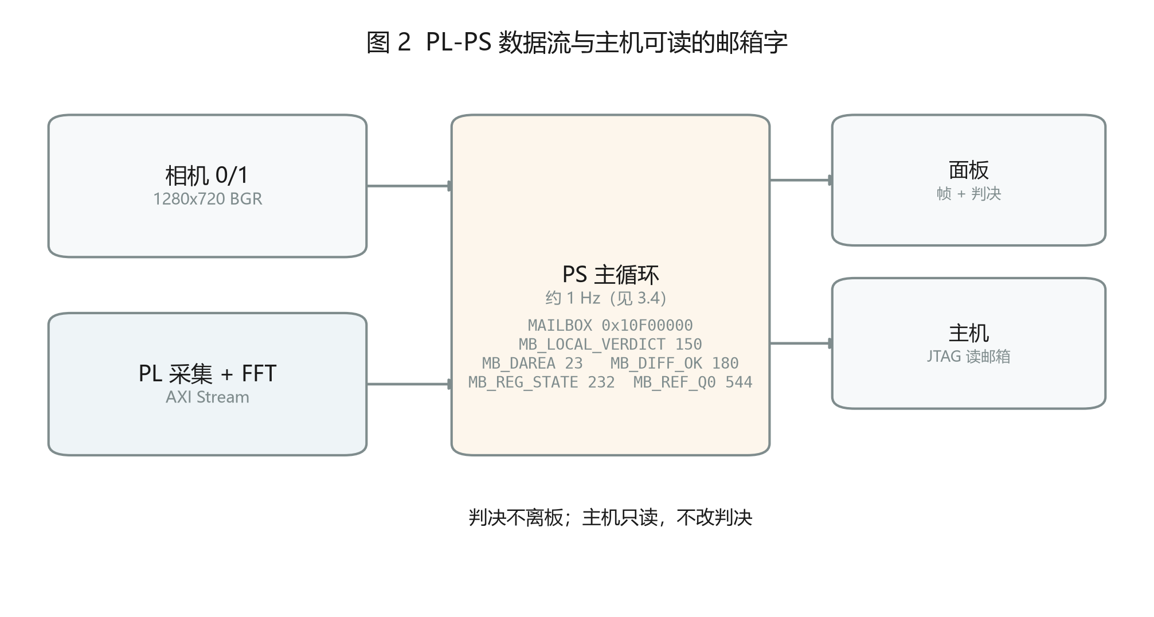
figures/fig2_dataflow.png
