www1453/trustscope/figures/fig3_grid.png

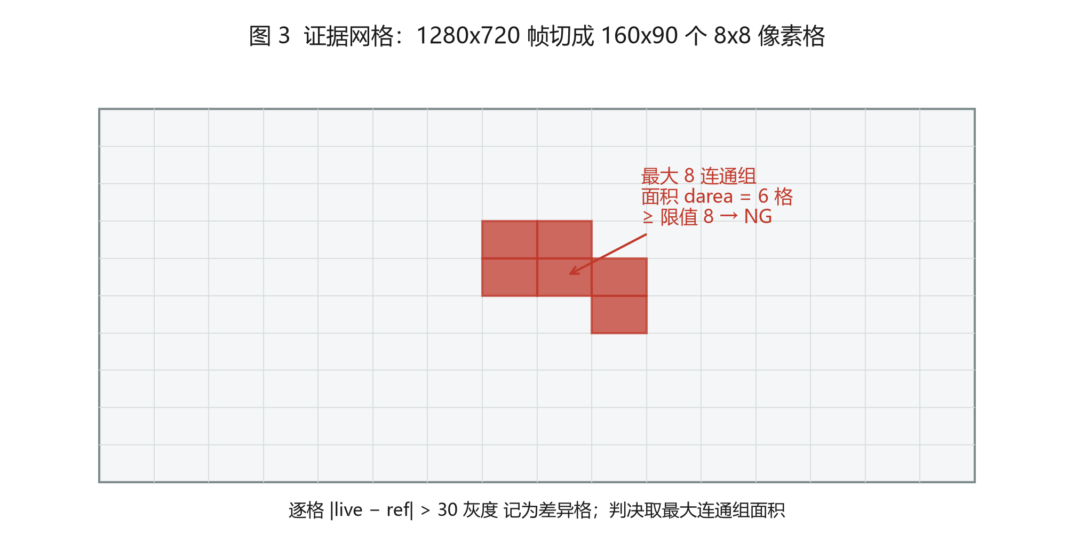
figures/fig3_grid.png
