www1453/trustscope/figures/fig4_corners.png

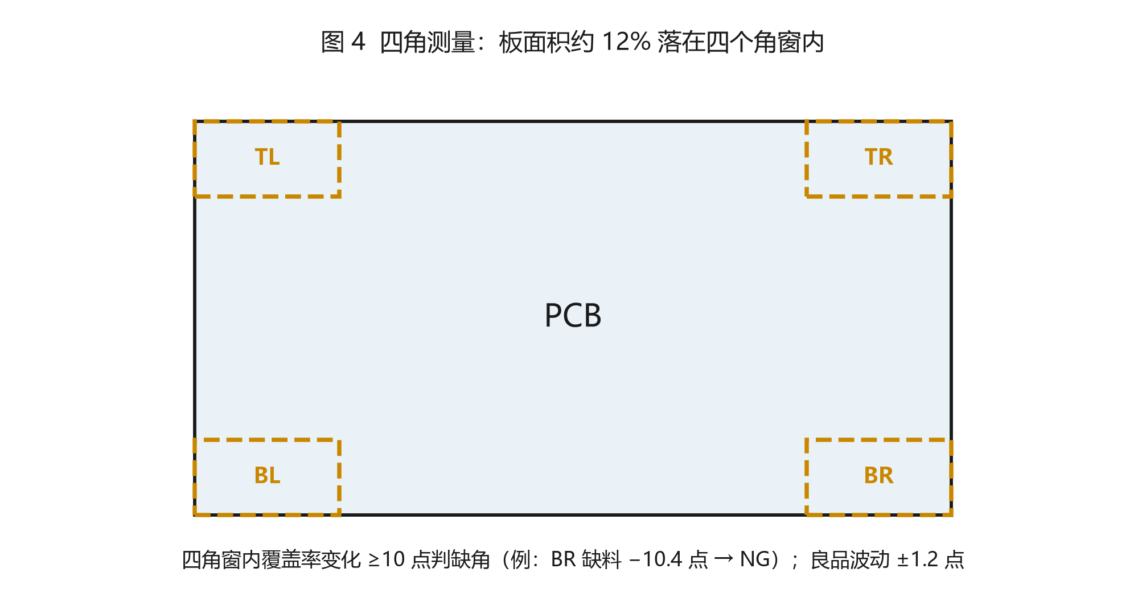
figures/fig4_corners.png
