www1453/trustscope/docs/BOM_20261101.md

# 物料清单与成本（BOM）· 2026-11-01

> 口径：只列**本工位实际用到**的硬件。单价一列**只在仓库里有记录时**才写数字；
> 盘上找不到价格的写 **unknown**，不估算、不引用市场价。
> 来源：`submission\data\shopping_and_todo.md`（采购决策，2026-10-13）、
> `dl\HARDWARE_SAFETY.md`、`dl\STM32_LINK_PROTOCOL.md`、`dl\CAMERA_BRINGUP.md`、
> `dl\HANDOVER_20261031_EVENING.md`、`submission\board\ARTEFACTS.md`。

## 一、主体清单

| # | 项目 | 数量 | 型号 / 规格 | 单价 | 合计 |
|---|---|---|---|---|---|
| 1 | 开发板 | 1 | ALINX **AX7020**，XC7Z020CLG400-2（Zynq-7020），板载 CP2102 USB-UART（接 PS MIO48/49） | unknown | unknown |
| 2 | 双目相机模块 | 2（1 在用 + 1 换发新件） | **AN5642**，每块模块 2 颗 OV5640（1280×720，DVP，插 J10）；原模块 S/N 005932 的模块内 +5V 走线烧断，换发件 S/N ≠ 005932 | unknown | unknown |
| 3 | 传送带皮带 | 1 | 停带式工位用；规格无记录。记录里两种说法并存：一处写"传送带已采购"（`submission\legacy\fpga_snapshot_20261019\docs\REPORT_DRAFT.md:197`），另一处写"传送带能不能借到（实验室公用器材，只能夹装不能拆）"（`submission\data\shopping_and_todo.md:109`）——**两种说法都在盘上，价格两者都没有** | unknown | unknown |
| 4 | 减速电机 | 1 | 规格无记录。实测边界：L9110S 驱动下 40% / 70% 占空比只嗡不动，**只有 100% 才带动皮带**（`dl\STM32_LINK_PROTOCOL.md` §7） | unknown | unknown |
| 5 | 电机驱动 | 1 | **L9110S**（STM32 侧 PA6/PA7 驱动，两根线） | unknown | unknown |
| 6 | 控制板 | 1 | **STM32F103C6** 最小系统板；固件产物在 `dl\build_stm32\conveyor.bin`（另有 `pin_test.bin`） | unknown | unknown |
| 7 | USB-TTL 模块 | 1 | **CH340**，PC 侧 COM 口（现为 COM8，旧记录 COM6）；115200 8N1 | unknown | unknown |
| 8 | 光源 | 1 | 显微镜 **LED60 环形光源**：60 颗灯珠、分体调光、内径 60 mm / 外径 93 mm、12 V、4.5 W、6500–7000 K、有效光聚 75 mm | unknown | unknown |
| 9 | 机架 / 俯拍支架 | 1 | **自制**（纸盒 / 木架；记录里的原话是"用纸盒子做个架子"）。材料费无记录 | unknown（自制，材料费未记录） | unknown |
| 10 | 电源 | 1 套 | 板电源 + 灯用 12 V；**型号、功率、单价均无记录**。已知的只有电压事实：J10 PIN2 供 +5V、J10/J11 为 BANK35 = 3.3 V | unknown | unknown |

## 二、其他记录在案的硬件（都没有价格）

| 项目 | 数量 | 型号 / 用途 | 出处 |
|---|---|---|---|
| JTAG 调试器 | 1 | Digilent **JTAG-HS1**，S/N 210512180081 | `dl\HARDWARE_SAFETY.md:457` |
| 显示触摸屏 | 1 | **AN970** 7 吋，800×480；面板 TM070RDH13 + 触摸 GT911 | `dl\HARDWARE_SAFETY.md:1634` |
| 备用相机模块 | 1 | **OV2640** 单目；用途是证明"板侧完好"（同板同总线换插后 PID/VER 四次读一致） | `dl\CAMERA_BRINGUP.md:168` |
| 单目 OV5640 模块 | 1 | 一条"已下单"的记录，**没有到货记录、没有价格** | `submission\report\design_report_draft.md:107` |
| PCB 裸板（工件） | 未计 | 记录里是**建议买法**"同批 10–20 片好板 + 几片自造缺陷"，不是订单 | `submission\data\shopping_and_todo.md:49` |

## 三、盘上唯一带价格的记录（不是本机采购）

| 项目 | 单价 | 性质 |
|---|---|---|
| 舵机（打点 / 分流执行器） | **¥10 / 个** | **决定记录**（"舵机 + 记号笔 / 舵机拨杆"），`submission\data\shopping_and_todo.md:121`；仓库里没有下单或到货记录 |
| 交叉偏振片 | ¥20–40 | **估价**，写在 `dl\STEREO_PLAN.md:117` 的方案比较里（"最便宜"），不是采购 |

## 四、成本说明

表中所有金额都是**仓库里能查到的、已记录的采购**。
写 `unknown` 的项，是盘上确实没有单价——**没有估算，也没有把估价或市场价填成采购**。
因此本工位**无法给出总价**：唯一有数字的一行是舵机的 ¥10/个，而它是决定记录、不是发票。
