www1453/trustscope/docs/SHOPPING_AND_TODO.md

# 采购决策与待办清单（2026-10-13 记，等临近交付再执行）

> 本文只记录**已做的判断与依据**，以及**执行前必须确认的事**。
> 目的：到 11/4 附近动手时，不需要重新推一遍。
>
> 时间表（已核实，来源：赛区公开通知 2026-09-09）：
> **作品提交 2026-11-04 18:00**，**决赛 2026-11-20 至 22**。

---

## 一、成像与工件

### 1. 环形光源 —— ✅ 买这个规格，但只买一个

**已看中的型号**：显微镜 LED60 环形光源（60 颗灯珠，分体式，亮度可调）

| 参数 | 值 | 判断 |
|---|---|---|
| 内径 / 外径 | 60 mm / 93 mm | ✅ 镜头穿得过去（**待确认**镜头外径） |
| 输出电压 | 12 V | ✅ 与系统一致 |
| 亮度调节 | 0–100% 旋钮 | ✅ 标定有用 |
| 色温 | 6500–7000 K | ✅ 彩色检测合适 |
| 结构 | 分体（控制器分离） | ✅ 环体轻、好装 |
| 功率 | **4.5 W** | ⚠️ 偏小 → 可能需缩短曝光 |
| 有效光聚 | **75 mm** | ⚠️ 显微镜的近距离 → **相机高度要按它设计** |
| 光源方向 | **环形（各方位同时照）** | ❌ **做不了多角度**（手动旋钮，不能逐帧切换） |

**它的定位（这是买它的核心理由，也是它的边界）**

| 缺陷类型 | 环形光 | 依据 |
|---|---|---|
| **反照率型**（缺件、短路、污染、焊盘氧化、色差） | ✅ **合适** | 无方向性正是它的用途；PCB 主要缺陷就是这一类 |
| **形状型**（划痕、压痕） | ❌ **很差** | 沟槽两面壁朝向相反，环形光同时照亮两面 → **明暗互相抵消**。实测单方向光已漏 **14%** 的划痕，环形光是所有朝向的平均，形状对比度进一步被抹平 |

→ **留一个"补一盏低角度暗场环"的余地**（暗场原理相反：靠缺陷散射光）。
→ **不要买 4 个**：它不能逐帧切换，做不了光度立体。

**下单前必须确认两件事**
1. **内径 60 mm 能否套过我们镜头的直径**（量镜头外径）
2. **75 mm 工作距离下我们得到的视场有多大** —— 这决定分辨率。
   现状：件只占 **5.8 px/mm**；目标 **12 px/mm**。
   **这条要用实际镜头算或试，不能拍脑袋。**

### 2. 工件 —— PCB 裸板（已定）

老师明确建议（聊天记录）：「比如这种 PCB 裸板」；且报名题目是**平面工件**。

**建议买法**：
- **同批 10–20 片好板** ← 关键：参考图法需要"一批一致的好件"，多买好板价值最高
- **几片自己造缺陷**：划伤（塞尺/划针）、污染（记号笔/油渍）、缺件（拆掉一个元件）

**PCB 的额外优势**（这是选它最值的地方）：
> **PCB 的合格长相是已知的** —— Gerber 可以渲染成"应该长什么样"，或拿确认过的好板当主参考。
> 这把"质检"从**"从零找异常"**变成**"查图纸"**，难度低一个数量级，而且**答辩时好讲**。

### 3. 俯拍支架

平面件必须从上往下拍。**纸盒/木架都行**，老师原话：「用纸盒子做个架子」。

---

## 二、多角度打光（可选，取决于评分点）

**要不要做 4 灯，取决于"评分点里有没有划痕类形状缺陷"**。已有的实测数据：

| 方案 | 划痕漏检 | 朝向依赖 |
|---|---|---|
| 单光源 | **10.2%** | 3.3× |
| PS 合成图（形状+反照率加权相加） | 9.8%，且 chip 全漏 | —— |
| **四路各自判定取或** | **0.0%** | 1.11× |

**若要做**：4 个 12V 透镜射灯（同批 6 个）+ 丢石头 4 路串口继电器 + 电源。
**但注意**：这条链要先解决继电器协议（点动/自锁、波特率、帧格式未知），
**可能烧 1–3 天**，是 22 天里风险最高的一项。

---

## 三、暗箱（零成本，优先做）

**纸箱 + 哑光黑内衬**。实测效果：

- 纸箱把环境光压到 **2.7% 满量程**（**17.1 倍**抑制）
- 噪声地板：**2.0 灰阶/像素**（灯亮）/ 1.6（灯灭）
- **内衬要哑光黑**（黑卡纸/植绒布），**不要用光面垃圾袋** —— 实测它会留下镜面反光斑，那些亮斑是**方向不确定的二次光源**
- **灯要在罩内、对准工件**。实测教训：白箱散光毁方向性；但把箱壁涂黑后件也进了黑洞（件区从 129.8 掉到 21.7）。**正确组合是"黑箱挡环境光 + 灯在箱内"**

---

## 四、软件侧已就绪（不需要采购）

| 能力 | 状态 |
|---|---|
| 光照归一化（抗灯衰减） | ✅ 已验证：灯暗 15% 时朴素引擎 **5/5 全漏**，加归一化后 **5/5 检出** |
| 相位相关配准（抗平移） | ✅ 已验证：平移时朴素引擎 **5/5 误报**，加配准后 **0** |
| 标定件自查（发现仪器漂移） | ✅ 已验证：阳性对照 0/5 报警、阴性对照 5/5 报警，分离度 **5.5 倍** |
| 参考图锁定 | ✅ 已验证：同一件连看 12 次分数**完全相同**（未锁定时第 6 次翻面） |

→ **"仪器必须稳定"这条要求，亮度和位置两项已经不用靠机械保证了。**

---

## 五、待确认清单（执行前逐条打勾）

- [ ] 我的**镜头外径**是多少？（决定环形光内径够不够）
- [ ] **75 mm 工作距离**下的视场有多大？换算成 px/mm 是多少？（目标 12 px/mm）
- [ ] **评分细则**里有没有"划痕/形状型缺陷"？（决定要不要上 4 灯）
- [ ] **11/4 提交的具体格式**（报告页数、要不要视频、要不要英文）—— 见赛事公告与提交页面
- [ ] PCB 板下单了没有（**货期在走时钟**）
- [ ] 传送带能不能借到（实验室公用器材，**只能夹装不能拆**）

---

## 六、记录：已达成的采购决策

| 项 | 决定 | 依据 |
|---|---|---|
| 工件 | **PCB 裸板**（同批多片好板 + 几片自造缺陷） | 老师建议 + 报名题目是平面工件 + **有已知参考图形** |
| 照明 | **环形光 ×1**（先），留低角度暗场余地 | 老师建议 + PCB 主要缺陷是反照率型 |
| 是否上 4 灯 | **待定**，取决于评分点 | 4 灯把划痕漏检从 10.2% 降到 0%，但机械/协议风险高 |
| 传送带分流 | **做，但用"停带式"** | 动态跟踪不可行（老师也指出）；且我们判定依赖稳定参考 |
| 打点/分流执行器 | **舵机 + 记号笔 / 舵机拨杆** | ¥10/个，一根 PWM 线，两种用途共用备件 |
| 控制架构 | **FPGA 做视觉，MCU 做其余** | 老师明确建议；且隔离风险（FPGA 作品占 30+20+20 分） |
