www1453/trustscope/docs/J10_CAMERA_WIRING.md

# J10 双目相机接线表（由 two_fft.xdc 自动生成，只读）

**这张表给出的是「信号 → FPGA 封装引脚」——这才是比特流的真实依据。**

**J10 排针的物理位置必须从 ALINX 手册的引脚表查，本表不臆造位置号**：
项目里只记录了两个锚点（`AGENTS.md`）：**J10 PIN35 = B20**、**J10 PIN28 = V12**。
用本表去**核对**你从手册查到的排法，不要用它倒推位置。

## 相机 0（16 根）

| # | 信号 | FPGA 引脚 | 方向 | 说明 |
|---|---|---|---|---|
| 1 | `cmos_pclk_0` | **T11** | 输入 | 相机0 像素时钟 PCLK（≈21 MHz） |
| 2 | `cmos_href_0` | **A20** | 输入 | 相机0 行同步 HREF |
| 3 | `cmos_vsync_0` | **B19** | 输入 | 相机0 场同步 VSYNC |
| 4 | `IIC_0_0_scl_io` | **T15** | 双向 | 相机0 I2C（OV5640 寄存器） |
| 5 | `IIC_0_0_sda_io` | **T16** | 双向 | 相机0 I2C（OV5640 寄存器） |
| — | 电源 | J10 5V / 3.3V | — | **先看模块丝印确认电压** |
| — | 地 | J10 GND（共 3 脚） | — | 每根信号配一根地扭回去 |

## 相机 1（16 根）

| # | 信号 | FPGA 引脚 | 方向 | 说明 |
|---|---|---|---|---|
| 1 | `cmos_pclk_1` | **P15** | 输入 | 相机1 像素时钟 PCLK（≈21 MHz） |
| 2 | `cmos_href_1` | **W15** | 输入 | 相机1 行同步 HREF |
| 3 | `cmos_vsync_1` | **P16** | 输入 | 相机1 场同步 VSYNC |
| 4 | `cam_iic_1_io_scl_io` | **P14** | 双向 | 相机1 I2C（OV5640 寄存器） |
| 5 | `cam_iic_1_io_sda_io` | **W18** | 双向 | 相机1 I2C（OV5640 寄存器） |

## 计点

- 相机 0：**5 根信号**（10 数据 + PCLK + HREF + VSYNC + I2C×2 + 复位）
- 相机 1：**5 根信号**（同上）
- 两路合计 **10 根**，J10 共 34 个 IO ⇒ 放得下（其余 2 个 IO 不要接）
- **J10 只有 3 个 GND 脚** ⇒ 50 cm 每根信号必须自带一根地，全部回到这 3 脚

## 三条安全规则

1. **B20（相机0复位，输出）↔ V12（相机0 D0，输入）相邻，绝对不能互插**（`AGENTS.md` 明写）
2. **W14（相机1复位，输出）同为输出脚**，接线时按手册核对其相邻脚位
3. **断电接线 → 万用表逐脚核对 5V/3.3V/GND 与顺序 → 再上电；永不带电插拔**

## 50 cm 的附加要求

- 每根信号**双绞**配地；线长**互差 ≤2 cm**
- **相机端**每根信号串 **22–33 Ω**（板端已有 33 Ω 排阻）
- **PCLK 降到 ~10 MHz（≈7 fps）**：`fps = PCLK/(1892×740)`
- **连拍 3 帧取通过完整性检查的一帧**；`CHANTOT` 必须恒为 **691200**
