www1453/trustscope/docs/REPORT_ASSEMBLY_20261102.md

# 报告装配记录 2026-11-02（works_report_20261102）

## 产物
- `submission/report/works_report_20261102.docx`（74,593 B）
- `submission/report/works_report_20261102.pdf`（830,952 B，**22 页**；%PDF-1.7，页数用三种方式计数一致）
- 模板 `works_report_20261101.docx` 与 `hardware_safety.md` 均未改动；装配脚本 `dl/build_report_20261102.py`，校验脚本 `dl/verify_report_20261102.py`

## 复用的样式（全部取自模板，未新建样式）
- 正文 `Normal`（模板正文段不带 pStyle）；标题 1/2/3 = `w:pStyle Heading1/Heading2/Heading3`（`w:name` 为 "heading 1/2/3"，中文界面即 标题 1/2/3）；表格样式 `Table Grid`
- 单元格沿用模板写法：Times New Roman + 宋体 sz19、表头加粗；页面直接沿用模板 `sectPr`：A4 11906×16838，页边距 1417/1417/1814/1814
- 模板**没有** TOC 域（fldChar=0、instrText=0）、没有页眉页脚部件、没有目录页；故无域可保留，也未手写页码

## 数量
- 表格 **9 张**：表 1-1、2-1、3-1、3-2、3-3、3-4、6-1、6-2、6-3；均 Table Grid、表头行加粗并跨页重复、列宽按内容拟合、行不跨页断开
- 占位符 **10 个**（图 4 + 照片 6）：斜体灰字 + 灰色底纹 + 四边框，正文中一眼可见；未插入任何图片（`w:drawing` = 0）
- 段落 174（Heading1 6 / Heading2 25 / Heading3 14 / Normal 129）；摘要为普通段落

## 完整性检查（在输出 docx 上执行，12/12 通过）
1. 无 "9/9" — 搜索 `9\s*/\s*9` → 0 次 PASS；缺角处为 7/7 且带 3+2+2
2. 无 "失败" — 搜索 `失败` → 0 次 PASS
3. 无学校串 — 搜索 `大学`/`学院`/`学校`/`队名`/`队伍`/`高校`/`中学` + 16 个高校名 → 0 次 PASS
4. 无裸百分比 — 正则 `(\d[\d,\.]*)\s*%` 命中 35 个，逐个查同句分母证据 → 0 个缺分母 PASS
5. 18/21 与 19/21 — 同单元格 + 同句判违规 → 0 处（全文 18/21 计 4 次、19/21 计 5 次）PASS
6. 三值拒判 — 搜索 `CANNOT JUDGE`：首现在第 5 个正文单元，第一部分在第 8 个 → 落在前两页 PASS
7. CNN — 判据：句含 `29–31 ms|ms/次|fps|KAT|8/8|加速比` 且不含 `未测|不给`；6 句全部含 `不在判决路径` PASS
8. 缺角 7/7 — 含 `7/7` 的单元 5 处，全部同时含 `离线|宿主侧` 与 `3+2+2|3/3` PASS

## 为过检查在 docx 里做的文本修改（未删任何句子）
- 摘要补 `（CANNOT JUDGE）`；7/7 后补 `批次构成 3+2+2 = 7`
- 污染 18/21 与 19/21：表 1-1、表 3-1 的污染行各拆成"账本口径 / 格点复算"两行；摘要与 1.2 各拆成两句
- CNN：`不接入判决路径` → `不在判决路径上`；2.1 与表 2-1 第 7 行补`（不在判决路径）`；图 2 图位同改
- 百分比补分母：LUT `36,513/53,200`、FF `58,900/106,400`（4 处）、BRAM `109.5/140`、88.7% 补 `数据路径 18.730 ns`、`亮度差 > 参考亮度的 10%`（3 处）
- 7/7 注①补`（该判据为宿主侧离线复算，尚未上板）`
- 封面免责句 `不含任何学校、队伍…` → `不含任何身份类信息`（原模板串含"学校"，会被该校验命中）
- 草稿未编号的三张表按位置补题：表 2-1（§2.4.1 PL 清单）、表 6-2（§6.4 复现入口）、表 6-3（§6.5 否证矩阵）
- 删去草稿 H1"…正文草稿"与"给排版者的三行说明"块（草稿自注"转 docx 时删除"）；摘要为正文段落——草稿无关键词段，未虚构
- 旧报告 4 张配图未带入（图位按指示保留为占位符），其 image 部件已移出包（docx 2.5 MB → 74.6 KB）

## 需人工确认
- 无遗留失败项。转档报 `missingFonts:["Courier"]`，正文/表格未使用 Courier（代码用 Consolas），不影响排版
