www1453/trustscope/docs/REPORT_ASSEMBLY_20261103.md

# 报告装配记录 2026-11-03（works_report_20261103）

## 产物
- `submission/report/works_report_20261103.docx`（76,822 B）
- `submission/report/works_report_20261103.pdf`（840,037 B，**24 页**，%PDF-1.7；页数两种方式一致：
  `/Type /Page` 计数 24、pdfium `pageCount` 24、第 25 页越界报错）
- 装配脚本 `dl/build_report_20261103.py`（= 1102 脚本 + `EDITS_1103` + `NEW_SECTION_337`），
  校验脚本 `dl/verify_report_20261103.py`（16 项，全通过）
- 模板 `works_report_20261101.docx`、`works_report_20261102.docx/.pdf` 均未改动

## 为什么出这一版
`works_report_20261102.docx` 装配于 2026-11-01 17:12，**早于**当晚 19:00–22:30 的现场实测；
`dl/FIELD_RESULTS_20261101.md` 写于 22:21。因此 1102 版只有离线归档数、没有现场数，且仍带提案语气。
本版只做三件事：补现场实测（3.3.7）、给全部归档数字加口径、把将来时改成完成时。**无硬件、无新测量。**

## 审计对照（在成稿 docx 上执行）

| 检查 | 1102（改前） | 1103（改后） |
|---|---|---|
| `18/21`、`19/21` | 4、5 | 4、5（未删，均加口径） |
| 裸 `90.5%` | 1 | 1（加口径） |
| `7/7`、`3+2+2` | 5、3 | 5、3 |
| `0/58`、`0/39` | 6、9 | 6、9（均加口径） |
| 现场数 `90%（18/20）` | 0 | 2 |
| 现场数 `80%（8/10）`、`80%（12/15）` | 0、0 | 2、2 |
| 现场数 `8.3%（3/36）` | 0 | 1 |
| 现场数 `0/16` | 0 | 5 |
| 现场窗口 `22:00–22:30` | 0 | 2 |
| `[NEEDS NUMBER]` | 0 | 0 |
| `计划` / `拟` / `将`（裸字） | 0 / 6 / 2 = 8 | 0 / 6 / 1 = 7 |
| 其中真·将来时 | `将` 1 处 | 0 |
| 其他计划语气（`列入下一阶段`、`【待填`） | 3 | 0 |
| 学校串 / world-leading | 0 / 0 | 0 / 0 |
| 归档数字总数 | 30 | 30 |
| 其中带 `实验室离线口径` | **0** | **30** |
| 表格 / 占位符 / 内嵌图 | 9 / 10 / 0 | **10** / 10 / 0 |
| 段落样式 | H1 6 / H2 25 / H3 14 / Normal 129 | H1 6 / H2 25 / **H3 15** / Normal 138 |

样式、表格样式（`Table Grid`）、节设置（A4 11906×16838，边距 1417/1417/1814/1814）、
10 个占位符（图 4 + 照片 6）全部沿用模板；文档属性仍为 `author=python-docx`，无页眉页脚。

## 3.3.7 新增小节（成稿文字）

见 3.3.7 正文；要点：单会话/单参考/单背景（2026-11-01 22:00–22:30）、跨会话不合并；
表 3-5 五行（污染 22/18/2/2 → 90%（18/20）；变形 11/8/2/1 → 80%（8/10）；缺角 15/12/3/0 →
80%（12/15）；良品 40/3/31/6 → 8.3% 误报（3/36）；细划痕 16/0/16/0 → 0%（0/16，能力边界））；
三句话逐字取自源文件；复测（b027 10→18、b031 8→8、b033 10→19；b017/b021/b034 回 OK）；
两个被否掉的通道各一句（`darea` 良品 1–19 / 污染 3–45 重叠；`maxd` 两者都 150–170）；
边界三句（划痕按设计判 PASS + 原因；CNN 已实现但未并入判决 + 根因；孔洞/缺口未实现）。

## 计划语气：逐条 before / after
8 处裸字命中里只有 1 处是将来时；其余 7 处是 **`拟合`（curve fitting）×6** 与
**`将来`（名词）×1**，改了会变成病句，故保持原样。真正按"完成时"重写的 4 句：

| # | 位置 | before | after |
|---|---|---|---|
| 1 | 1.3 ①（唯一真·`将`） | 据此确立"换参考必重扫"的会话纪律，**并将其写入运行手册**。 | 据此确立"换参考必重扫"的会话纪律，**并已写入运行手册（见 2.6 手册摘录）**。 |
| 2 | 3.3.5 末 | 量化 CNN 的 PS 基线**列入下一阶段**。 | 量化 CNN 的 PS 基线**未测（见 3.4 第 6 条）**。 |
| 3 | 6.6 末 | 量化 CNN 的 PS 基线**列入下一阶段**。 | 量化 CNN 的 PS 基线**未测（见 3.4 第 6 条）**。 |
| 4 | 表 3-4 soak 行 | **【待填：**出货镜像 30 min 连续运行 —— 采样数 / 时长 / `diff_ok` 全 1 的比例 / 判决分布**】** | **未测**：出货镜像的 30 min 连续运行（采样数 / 时长 / `diff_ok` 全 1 的比例 / 判决分布） |

## 口径限定词（统一一句）
`实验室离线口径`。两种落位，措辞只有一个：
- 数字已有括号 → 并入该括号：`19/21（实验室离线口径；良品 0/39）`、`18/21（实验室离线口径，账本）`
- 数字无括号 → 补一个括号：`良品 0/41–0/39（实验室离线口径）`
- 摘要里被写成汉字的 `21 块板检出 18 块`、`21 块污染板拦截 19 块` 也一并加口径。

定义句只出现一次（3.3 口径段）：「本报告中凡标"（实验室离线口径）"的数，都是实验室归档帧的
离线复算，不是 11-01 现场实测；现场整批判定的数见 3.3.7。」成稿里 30/30 处归档数字携带该限定。

## 顺带修掉的三处自相矛盾（数字与实测不符）
现场表说细划痕 16 块**全部读 OK、0 块拒判**，而 1102 正文三处写"本工位对它输出 2 而不是假 OK"。
按实测改正（并在 3.3.7 边界三句里写成"按设计判 PASS + 原因 + 工序分工"）：
1. 摘要末句 → 现场 16 块全部读 OK（0/16 NG，见 3.3.7），是能力边界，OK 不作为合格证明。
2. 3.3.4 末句 → 由人工复检工位承担；本工位对它输出 OK（现场 16 块，0/16 NG）。
3. 6.5 收敛结论 → 输出 OK 而不是检出；既不算检出、也不算漏检。
另修 1.2 一处由 1102 自动改写留下的悬空括号（`…口径见 3.3），` → `…口径见 3.3；`）。

## 未能满足 / 需要源数据侧决定的两项

1. **良品行算术不自洽（源数据的，不是本次编辑引入的）**：表 3-5 印的是源文件的
   `8.3% 误报（3/36）`，但同一行给出 n=40、拒判／不稳=6，即 40−6=34 块可判，
   3/34 = 8.8%。36 这个分母在任何存档里都找不到出处。本报告按要求逐字照印，不自行重算；
   若要改成 8.8% 或补一句分母说明，需源数据侧确认后重跑 `dl/build_report_20261103.py`。

2. **"单会话 22:00–22:30" 无法从原始记录独立核验**：
   - 分母可追溯：`dl/qc_order_20261101.csv`（100 块：g40/c22/b11/s16/k11）+ `dl/qc_order_extra_20261101.csv`
     的 4 块缺角板（C108–C111）= **104 块**，恰好是表 3-5 的 40/22/11/15/16。
   - 逐块判定不可追溯：唯一的邮箱记录 `dl/qc_all_20261101.csv` 是**追加写**文件，跨 19:15–22:12
     多次会话，且**中途改了列**（前 137 行 14 列、末 20 行 15 列，新增 `maxd` 但表头没改），
     其中 22:00 之后只有 20 行（b001–b020），没有 104 块的整块记录；`dl/fused_20261101/` 里只有
     18 块板的原始帧，且没有 run.json。
   - 因此 3.3.7 的"单会话、单参考、单背景、22:00–22:30"是照 `dl/FIELD_RESULTS_20261101.md`
     的记载印的（该文件是任务指定的定稿口径），不是本次核验的结果。

## 复现
```
python dl\build_report_20261103.py         # md + 1102 修补 + 1103 修补 -> docx
python dl\verify_report_20261103.py        # 16 项完整性检查
"<node>" "<libreoffice-kit>\lib\cli.js" convert \
    --input submission\report\works_report_20261103.docx \
    --output submission\report\works_report_20261103.pdf
```
转档仍报 `missingFonts:["Courier"]`（与 1102 相同，正文/表格未使用 Courier）。

## 二次修订（2026-11-03，源数据侧决定后冻结）

上文记录的是第一次装配时的状态；以下两处按源数据侧的裁定改写，**取代**上文对应内容：

1. **良品行算术改正**：`8.3% 误报（3/36）` → **`8.8% 误报（3/34）`**。理由：n=40、拒判／不稳=6，
   可判分母 = 40−6 = 34，3/34 = 8.8%；`36` 无出处。改了两处（表 3-5 良品行、3.3.7 第③句）。
   全文 `8.3` = 0、`3/36` = 0；`3/34` = 2。注意 `dl/FIELD_RESULTS_20261101.md` 仍写
   `8.3%（3/36）`（源文件未改，本报告不再引用该处的数）。
2. **会话口径软化**：删掉"采集与判决窗口 2026-11-01 22:00–22:30"的断言（3.3.7 §① 与表 3-5 标题），
   改为「本表数据采集于 2026-11-01 晚间同一台设备、同一固件镜像、同一套光学条件下；分母（104 块）
   可从作业单独立追溯，逐块判定记录以追加写方式留存（`dl/qc_all_20261101.csv`），其时间戳跨越
   19:15–22:12，本节不再就"严格连续"作更强声明。」；保留"跨会话不合并"与"一块参考板、一个背景"。
   全文 `22:00` / `22:30` = 0，`晚间` = 2，`19:15–22:12` = 1。

改后：docx 76,956 B、PDF 841,226 B、**24 页**（未增减）；`dl/verify_report_20261103.py`
扩到 **17 项**（新增"旧数 8.3 / 3/36 已清零"），17/17 通过；占位符仍 10（图 4 / 照片 6），
表格 10、段落 184；3.3.7 落在第 17–18 页，表 3-5 整表不跨页，3.4 标题与其条目同页，无溢出、无孤行。
上文"未能满足"第 1 项（良品算术）与第 2 项的一处表述（22:00–22:30）到此关闭。
