www1453/trustscope/docs/VIRTUAL_PHOTOEYE_RESULT_20261101.md

# 虚拟光电开关 · 结果（2026-11-01）

## 结论（E1）
停带判据已按 §2/§3 换掉并通过离线判据回放 + 上板连通验证；**停带位置、两次判决、三次重复未测**
——**皮带上没有板**（帧图目视确认：空白皮带），放板/取板必须人做，本 agent 无法执行。

## 改了什么
`dl/belt_pos_20261101.py`：bbox 中心闭环 → **四门虚拟光电开关 + 停后静止精修 + 三态判决**。
三项修复（心跳线程 / 启动 STOP 清 FAULT / 常驻轮询器）原样保留，未重写工具。
`ps_fft_dual/poll_bbox_20261101.tcl` **未改**（同时被 `belt_cycle` 使用）：缺的 `pts` 字段由本文件给
**生成的副本**追加，并对锚点做断言——替换不到就 `raise`，不允许静默退化成"只有三门的开关"。

## 标定得到的 TRIG_BX1
**`TRIG_BX1 = 112`（未标定）**。§5 要求手动把良品停在 `dx≈0` 读静态 `bx1`（预期 110–120）后反写；
无板，此步未执行，112 是规格书预期区间的中值，**不是测量值**。`PTS_GATE=300`、`BX0_WIN=(30,70)` 同。

## 三次重复的位置
**未测**（无板）。

## 两块板的判决
**未测**：良品应 OK、墨污板应 NG（`darea≥8`），两者都要上板。

## 测到了什么（每条带对照）
| 量 | 值 | 依据 |
|---|---|---|
| 四门回放 | **8/8 通过** | §1 的 6 行真实轨迹**全部不触发**：`110..135` 被 bx0 窗挡、`39..70` 被 bx1 挡、`4..63` 被"未完全进画"挡；2 个真板样本触发 |
| 轮询周期 | **142 → 168 ms**（加 pts 后，40 样本，min 150 / p90 187） | 2 连续帧 = **2.0 格**；规格书"≈200 ms ≈1.2 格"同量级 |
| 看门狗 | 12 s 实跑故障计数 **3→3，增量 0** | 对照 `run_cmds` **1064→1065**，证明窗口真的发生过（否则"没涨"可能什么都没跑） |
| 空台判决 | **CANNOT JUDGE**（`diffok=5 reg=2`） | 验收第 4 条，已测到：**空台不会被判 OK** |
| 邮箱活性 | frames 25469 → 26513 | 排除"读到的是静态残留" |
| 皮带是否在动 | **无法判定** | 帧差 静止 2.486 vs 运行 2.637，比值 1.06 落在噪声里；白皮带无纹理，**此测量对运动不可见**，不作结论 |
| 每块一行 | `dl/belt_pos_20261101.log` | 本次 2 行为 `NO TRIGGER`（空台）、1 行 `empty_stage/CANNOT JUDGE` |

## 未测（单列）
- 未测：停带位置 76–82 与三次跨度 ≤6 格，因为皮带上无板，需要人放一块良品跑 `--boards 3`。
- 未测：良品 OK / 墨污板 NG，因为同上，需要两块板各跑一次（墨污板要求 `darea≥8`）。
- 未测：`TRIG_BX1` 实测值，因为需要人把板停在 `dx≈0`。
- 未测：`dx` 的**正负号约定**（nudge 该向前还是向后），因为 `reg=2` 时 dx 无效。首次上板跑
  `--boards 1` 即可确定：若 `|off2|>|off1|`，日志会写 `nudge worsened`，不会静默。
- 未测：第 2 步判据"`reg=1` 且 dx 每帧在变"——已跑，**不通过**（`reg=2`、dx 冻结 `-928`）。
  这与"无板"一致（参考有效 `refq=0` 已复核）；有板后才是有意义的检验。
- 未测：连续 5 块不掉链，因为需要人连续放板。

## 已知风险（不掩盖）
- 10-31 §10：单次 1.0 s 开环行程 **5 / 14 / 18.5 / 32.5 格（打滑）**。静止精修的 `run_for(|off|/6)` 是
  **开环**，残余误差只有下一次 `dx` 读回才能测到；`|off|≤3` 时不做修正。
- 若 `poll_bbox_20261101.tcl` 被回退成仓库里的 12 字段版本，锚点失配会**立刻报错退出**，不会静默少一个门。
