www1453/trustscope/data/FIELD_RESULTS_20261101.md

# 现场实测结果（定稿）· 2026-11-01 晚

> **单参考、单背景、逐块可追溯**（主运行 21:02–21:38；batch 6 首测 21:41–21:45；复测 2026-11-01 22:02–22:12）。
> **跨会话不合并成"连续一次"**；同一块板以复测覆盖第一次判定，每块板一次裁定。
> 分母来自作业单：`dl/qc_order_20261101.csv`（B001–B100）＋ `dl/qc_order_extra_20261101.csv`（C101–C111）= **111 块**。

## 一、逐格通道 + 四角通道（全作业单 111 块）

| 类 | 批次 | 限值 | n | NG | **可判 NG 率** |
|---|---|---|---|---|---|
| **污染** | B001-B100 22 ＋ C101-C111 3 | 8 | 25 | **18** | **72.0%**（18/25） |
| **变形** | B001-B100 11 ＋ C101-C111 4 | 8 | 15 | **10** | **66.7%**（10/15） |
| **缺角**（四角通道） | B001-B100 11 ＋ C101-C111 4 | 四角 10 点 | 15 | **12** | **80.0%**（12/15） |
| **三类合计**（能力内） | B001-B100 44 ＋ C101-C111 11 | 8／四角 10 点 | 55 | **40** | **72.7%**（40/55） |
| **良品**·单次现场 | B001-B100 40 | 8 | 40 | **6** | 误报 **15.0%**（6/40） |
| **良品**·复测裁定 | B001-B100 40 | 8 | 40 | **3** | 误报 **8.8%**（3/34）；全体 7.5%（3/40） |
| **划痕** | B001-B100 16 | — | 16 | 0 | **0%**（0/16，能力边界） |
| **全类合计**（含边界类） | B001-B100 89 ＋ C101-C111 11 | — | 111 | **40** | **56.3%**（40/71） |

主运行单会话锚点（batch 1-5）：**36/48 = 75.0%**；batch 1-5 复测修正：**38/48 = 79.2%**（只带 batch 1-5 限定，不作全表口径）。
拒判／不稳 **7/89**；四角芯片跨四批 **26/29**（零误报，其中 3 块对 ±0.5 点敏感）。
同一 40 块良品的两个口径不重复计入合计；56.3% 的分母 71 块 = 能力内 55 块 ＋ 划痕 16 块。

## 二、复测确认的三块稳定误报

| 板 | 第一次 | 第二次 | 结论 |
|---|---|---|---|
| **b027** | NG 10 | **NG 18** | 稳定误报 |
| **b031** | NG 8 | **NG 8** | 稳定（在限值上） |
| **b033** | NG 10 | **NG 19** | 稳定误报 |

**另三块（b017 8→OK、b021 9→OK、b034 9→OK）复测回 OK——第一次是放板偶发。**

**翻转与高读数的归因（2026-11-03 复算，`dl/recompute_field_20261103.py`）：b068 稳定复现 `darea` 45（不翻转）；b073 与 C101 在复测中翻成 NG（C101 复测 (8,8) 翻 NG）。翻转集中在限值边缘（`darea` 5→10、5→8），是摆位敏感的边界效应。**

## 三、两个被判据否掉的通道

| 判据 | 数 | 结论 |
|---|---|---|
| **面积 `darea`** | 良品 1–19、污染 3–45 | **重叠，无干净阈值** |
| **最大幅值 `maxd`** | **良品与污染都是 150–170** | **无区分力**（那 150+ 的格是高光/边缘，不是缺陷） |
| **四角覆盖** | 缺角 −10 到 −21；良品 ±1.2 | **唯一分得开的通道** |

## 四、报告 §3.3 的三句话（定稿）

> **① 能力内三类缺陷、全批次判定的检出：污染 72.0%（18/25）、变形 66.7%（10/15）、缺角 80.0%（12/15），三类合计 72.7%（40/55）；主运行 batch 1-5 单会话锚点 36/48 = 75.0%。**
> **② 细划痕 0/16——这是 12 条统计量否证后的已知能力边界，不是漏检。**
> **③ 良品误报两个口径各自标注：单次现场（生产口径）6/40 = 15.0%；复测裁定 3/34 = 8.8%（可判）、3/40 = 7.5%（全体）。本报告不声称零误报。**

## 五、可靠性（soak）

**放在交付前跑**：一块板在位、灯常亮、静止，记录连续运行时长、判定次数、异常次数、有无重启。
**不要关灯、不要撤板**——那样测到的是"空转"，不是判决循环。

**实测（2026-11-02 夜 → 11-03 晨，出货镜像）：10.20 h / 12,626 次采样 / OK 12,594（99.7%）/ NG 0 / 拒判 32（0.3%，全部落在前 30 分钟，启动瞬态）/ 1 次重启（原因未定位，前后判决一致）/ `darea` 有效值 0–2。成稿见 `dl/SOAK_SECTION_20261103.md`。**
