www1453/trustscope/(commit log)

2026-11-03 TrustScope: a Zynq-7020 AOI station that refuses rather than guessing
    [qc_all_20261101.csv, qc_fused_20261101.csv, soak_20261101.csv]
2026-11-03 README: four blocks only; the 10-21 experiment record moves to docs/
    The front page is now what the project is (3-4 sentences), the frozen metrics
    block, the two reproduction legs, and navigation. Nothing else.
    - metrics block moved byte-for-byte: the 10 lines extracted from HEAD and from
    the new README are 873 bytes each and `git diff --no-index` between them is
    empty (sha256 9d4b8e76...). Moved from lines 9-18 to lines 16-25.
    - reproduction has two legs: the toolchain (Vivado/Vitis 2023.1, XC7Z020, the
    src/ material this repo actually carries) and the data leg (the three
    commands plus what each prints).
    - docs/HISTORY_20261021.md carries the moved record with the three-rate header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
2026-11-03 readme+tools+build: fix four review findings
    1. README section 1: replace the on-board-only claim with the two-channel wording (README.md and README.en.md); moved history checked, no other such sentence. 2. tools: the scratch row printed a doubled percent (0.0%%); it now prints 0.0% (recompute_field), threshold_sweep prints 0/16 = 0.0% at t=8, and the README typo note is removed. 3. src/hls + src/build: add the HLS CNN sources and the BD/build/XSA-export Tcl from the parent project; no bitstream. 4. both READMEs checked for a page-wide fence: none (both start with a heading).
2026-11-03 the report stops saying its judging needs no host, and stops calling the degraded cycle the machine. Two over-claims, one rebuild (works_report_20261103f), and the repository now carries that report 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
    1. THE HOST-SIDE CORNER CHANNEL. 缺角 12/15 sits inside the 40/55 headline, and it is
    made by the four-corner coverage channel, which runs on the station controller -- yet
    the report said "全部判定在板端裸机 PS 上完成，判定不依赖上位机" in the 摘要 and
    "判决管线运行于……判定不依赖上位机" in §1.3 ⑥. A reader who meets the corner row
    after that sentence has been told the opposite of what the row does. Both now sc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
2026-11-04 sync: the final submission package -- paths made relative, usernames removed, links fixed
    [qc_order_20261101.csv, qc_order_extra_20261101.csv]
